jawher-Mansour/MedTronic-Ventilator/ReadMe.txt

Open Source Ventilator from Medtronic 

Medtronic-PB-560
