jawher-Mansour/MedTronic-Ventilator/PB560 - Electrical Schematics/4096600.E01.001_Schma Carte Connexion Batterie IND02.pdf

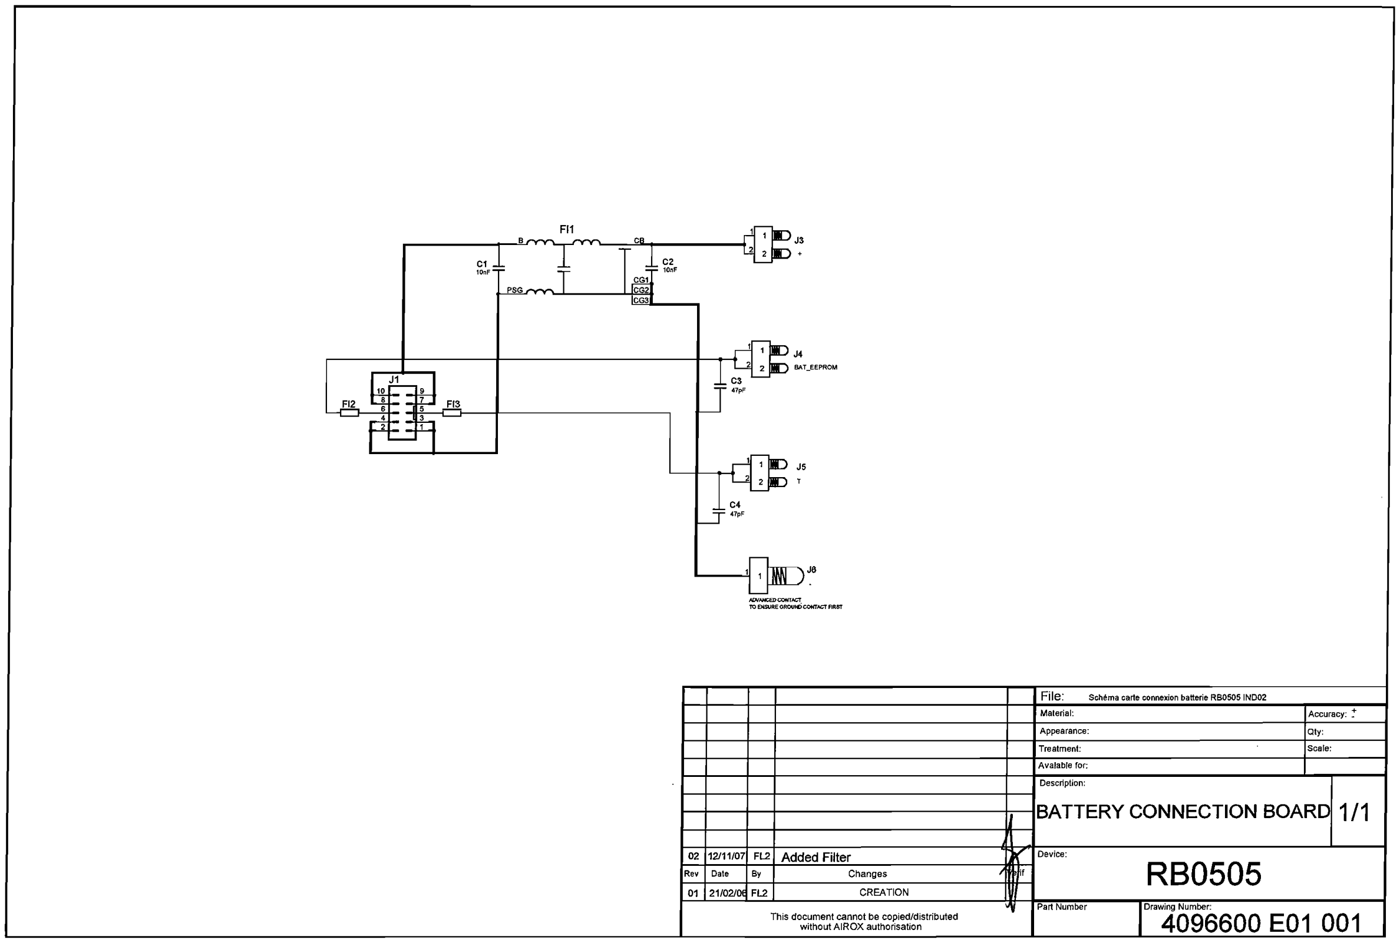
[picture p15: page 1]
