jawher-Mansour/MedTronic-Ventilator/Electronic PCBAs/10096510_Battery_Connection_PCBA/BOM/10096510_Battery_Connection_PCBA_BOM.xls

Creator | Jenaro | Julio
Type
Description
Title Block
Item Number | Description | Subclass | Lifecycle Phase | Rev | Rev Incorp Date | Rev Release Date | Effectivity Date
10096510 | BATTERY CONNECTION CARD RB0505 | Part | Production | A ECO-R252633 | 31/Jul/2013 05:52:42 PM BST | 06/Jan/2015 04:58:11 PM GMT
Page Two
UOM | Additional Categories Part | Alternate Part(s) | Alternate FG Part(s) | Restricted Access | Vendor User Group | Data Classification | Attachment Destination | Created By | Create Date | Legacy Data Source | Divesture Destination
Each | PART CATEGORY|Pc Board |  |  |  | V - Jabil SH | Confidential |  | Searcy, Teresa | 12/Jun/2012 01:54:35 PM BST | Agile RMS
Page Three
Product Family(s) | Item Type | Lot Serial Control | Document Number | RoHS Compliant | Bio Approval Number | Integration Description | Project(s) | Notes | Handling/Storage | Legacy Number
 | Customized | None | NODOCUMENT | Unknown |  | BATTERY CONNECTION CARD RB0505 | RSP - PB560-520 | Product Family : RSP - VENTILATOR SYSTEMS, Commodity Code: BPCS Add-Updt : FC02.17, Country of Origin: BPCS Add : FR = FRANCE, Shelf Life Days:BPCS Add-Updt : 0, Must Single Issue: BPCS Add : NO, Item Class: BPCS Add-Updt : GL-66 PB500 Series Ventilators/Gen 1, Controlled AML? : YES
BOM
Level | Attachments (Image) | Manufacturer (Image) | Pending Changes (Image) | Has Been Redlined (Image) | Has Quality(Image) | Bubble Number | Item Number | Item Description | Item Rev | Qty | UOM | Item Lifecycle Phase | BOM Notes | Ref Des | Component Effective From | Component Discontinue Date | Alternate Part(s) | Alternate FG Part(s) | Alternate Document(s) | Subclass | Sites | Planned? | Scrap Factor | OP # | Thumbnail | Attachments(Image) | Manufacture Part Has Redline | Mfr. Name | Mfr. Part Number | Mfr. Part Description | Mfr. Part Lifecycle Phase | Preferred Status | Sites | Reference Notes | RoHS Compliant? | RoHS Compliance Statement
1 | true | true | true | false | false | 0 | 10022508 | CAPACITOR CERAMIC,10NF,+/-10%,50V,0603 | C ECO-R252633 | 2 | Each | Production |  | C1,C2 |  |  |  |  |  | Part | BDRM |  | 1 |  |  | true | false | YAGEO_RMS1 | 223858615636 | CAPACITOR, CERAMIC, MULTILAYER, 50 V, X7R, 0.01 UF, SURFACE MOUNT, 0603 | Active | Preferred |  | BRAND: PHYCOMP | Yes | Legacy Inventory Status: Cleared
 |  |  |  |  |  |  |  |  |  |  |  |  |  |  |  |  |  |  |  |  |  |  |  |  |  | true | false | YAGEO_RMS1 | 223858615536 | CAPACITOR, CERAMIC, MULTILAYER, 50 V, X7R, 0.01 UF, SURFACE MOUNT, 0603 | Active | Preferred |  | BRAND: PHYCOMP | Yes | Legacy Inventory Status: Cleared
 |  |  |  |  |  |  |  |  |  |  |  |  |  |  |  |  |  |  |  |  |  |  |  |  |  | true | false | KEMET_RMS1 | C0603C103K5RACTU | CERAMIC CHIP CAPACITOR | Active | Preferred |  |  | Yes | Legacy Inventory Status: Cleared
 |  |  |  |  |  |  |  |  |  |  |  |  |  |  |  |  |  |  |  |  |  |  |  |  |  | true | false | YAGEO_RMS1 | CC0603KRX7R9BB103 | CAPACITOR, CERAMIC, MULTILAYER, 50 V, X7R, 0.01 UF, SURFACE MOUNT, 0603 | Active | Preferred |  |  | Yes | Legacy Inventory Status: Cleared
1 | true | true | false | false | false | 0 | 10022532 | FILTER CC, 1MHZ-1GHZ, 10A, 50V | B EC130338 | 1 | Each | Production |  | FI1 |  |  |  |  |  | Part | BDRM |  | 1 |  |  | true | false | MURATA MANUFACTURING CO., LTD. | BNX002-01 | FILTER | Active | Preferred |  | ROHS EXEMPTION: 7(C)-1 | Yes - by exemption | Legacy Inventory Status: Cleared
 |  |  |  |  |  |  |  |  |  |  |  |  |  |  |  |  |  |  |  |  |  |  |  |  |  | true | false | MURATA MANUFACTURING CO., LTD. | BNX00201 | NOISE/EMI SUPPRESSION FILTER | Active | Preferred |  | ROHS EXEMPTION: 7(C)-1 | Yes - by exemption | Legacy Inventory Status: Cleared
 |  |  |  |  |  |  |  |  |  |  |  |  |  |  |  |  |  |  |  |  |  |  |  |  |  | true | false | MURATA MANUFACTURING CO., LTD. | BNX002-11 | NOISE/EMI SUPPRESSION FILTER | Active | Preferred |  |  | Yes | CLEARED
1 | true | true | false | false | false | 0 | 10022623 | CAPACITOR,47 PF,+/-5%,50V,0402 | C ECO-R252636 | 2 | Each | Production |  | C3,C4 |  |  |  |  |  | Part | BDRM |  | 1 |  |  | true | false | KEMET_RMS1 | C0402C470J5GAC | CAP,CER,SMT,0402,5%,50V,47PF | Active | Preferred |  |  | Yes | Legacy Inventory Status: Cleared
 |  |  |  |  |  |  |  |  |  |  |  |  |  |  |  |  |  |  |  |  |  |  |  |  |  | true | false | SAMSUNG_RMS1 | CL05C470JB5NNNC | CAP CER 47PF 50V 5% NP0 0402 | Active | Preferred |  |  | Yes | Legacy Inventory Status: Cleared
 |  |  |  |  |  |  |  |  |  |  |  |  |  |  |  |  |  |  |  |  |  |  |  |  |  | true | false | MURATA MANUFACTURING CO., LTD. | GRM1555C1H470JA01D | CAP CER 47PF 50V 5% NP0 0402 | Active | Preferred |  |  | Yes | Legacy Inventory Status: Cleared
 |  |  |  |  |  |  |  |  |  |  |  |  |  |  |  |  |  |  |  |  |  |  |  |  |  | true | false | KEMET_RMS1 | C0402C470J5GACTU | CAP,CER,SMT,0402,5%,50V,47PF | Active | Preferred |  | TAPE & REEL | Yes | Legacy Inventory Status: Cleared
 |  |  |  |  |  |  |  |  |  |  |  |  |  |  |  |  |  |  |  |  |  |  |  |  |  | true | false | MURATA MANUFACTURING CO., LTD. | GRM1555C1H470JZ01D | MONOLITHIC CERAMIC CAPACITOR | Active | Preferred |  |  | Yes | Legacy Inventory Status: Cleared
1 | true | true | false | false | false | 0 | 10022907 | SMD FERRITE 200MA | B ECO-R252636 | 2 | Each | Production |  | FI2,FI3 |  |  |  |  |  | Part | BDRM |  | 1 |  |  | true | false | WURTH ELEKTRONIK GMBH | 74279266 | MULTILAYER-SMD-FERRITE | Active | Preferred |  | ROHS EXEMPT : 7(C)-1 | Yes | Legacy Inventory Status: Cleared
1 | true | true | true | false | false | 0 | 10023418 | CONNECTOR, 10 CONTACTS, HE10 | A ECO-R252633 | 1 | Each | Production |  | J1 |  |  |  |  |  | Part | BDRM |  | 1 |  |  | true | false | HARTING | 09185107323 | CONNECTOR | Active | Preferred |  |  | Yes | Legacy Inventory Status: Cleared
1 | true | true | false | false | false | 0 | 10023419 | CONNECTOR, 1 CONTACTS, TEST PROBE | A ECO-R252636 | 1 | Each | Production |  | J6 |  |  |  |  |  | Part | BDRM |  | 1 |  |  | true | false | INGUN | GKS 913 305 230 A 15 02 S | TEST PROBE | Active | Preferred |  |  | Yes | Legacy Inventory Status: Cleared
1 | true | true | false | false | false | 0 | 10023420 | CONNECTOR, 2 CONTACTS, PIN SPACE 2.54, SM | B ECO-R252636 | 3 | Each | Production |  | J3,J4,J5 |  |  |  |  |  | Part | BDRM |  | 1 |  |  | true | false | PRECI-DIP (015220) | 811-S1-002-30-014101 |  | Active | Preferred |  | ROHS EXEMPTION: 6(C) | Yes - by exemption | Legacy Inventory Status: Cleared
1 | true | true | true | false | false | 0 | 10096506 | PRINTED CIRCUIT, BATTERY BOARD | A MC002637 | 1 | Each | Production |  |  |  |  |  |  |  | Part | BDRM |  | 1 |  |  | true | false | TTM | 10096506 |  | Active | Preferred |  |  | Yes | Legacy Inventory Status: Cleared
1 | true | false | true | false | false | 0 | 4096600.E01.001 | BATTERY CONNECTION BOARD SCH | 02 ECO-R256396 | 1 |  | Production |  |  |  |  |  |  |  | Document | BDRM |  | 1
1 | true | true | true | false | false | 1 | 3838600 | PC BOARD TRACABILITY LABEL | C ECO-R252633 | 1 | Each | Production |  |  |  |  |  |  |  | Part | BDRM |  | 1 |  |  | true | false | BRADY_RMS1 | 3838600-H | B-727 LABEL, POLYIMIDE, GLOSSY WHITE THERMAL TRANSFER PRINTABLE LABEL STOCK | Active | Preferred |  | CUSTOM LABEL PER COVIDIEN DRAWING 3838600 | Yes | Legacy Inventory Status: Cleared
Manufacturers
Attachments(Image) | Manufacture Part Has Redline | Mfr. Name | Mfr. Part Number | Mfr. Part Description | Mfr. Part Lifecycle Phase | Preferred Status | Sites | Reference Notes | RoHS Compliant? | RoHS Compliance Statement
true | false | JABIL SUPPLIER - SHANGHAI UPP CO.,LTD.(LOC) | 10096510 |  | Active | Preferred |  | CUSTOM PART PER COVIDIEN P/N 10096510 | Yes | Legacy Inventory Status: Cleared
Attachments
Is Checked Out | Has Been Redlined | Filename | File Description | File Size | File Type | Attachment Type | Modified Date | Last View Date | Checkout User | Checkout Date | Checkout Location | Checkin User | Folder Number | Folder Version
false | false | 10096510_A_ECO-R231090.pdf | RMS Historical PDF - ECO-R231090 | 101554 | pdf |  | 17/Aug/2015 04:53:42 PM BST | 17/Aug/2015 04:53:42 PM BST |  |  |  | Migration, Data | FF0009842505 | 1
false | false | 10096510_A_ECO-R252633.pdf | RMS Historical PDF - ECO-R252633 | 101542 | pdf |  | 17/Aug/2015 04:53:43 PM BST | 17/Aug/2015 04:53:43 PM BST |  |  |  | Migration, Data | FF0009842506 | 1
false | false | 10096510X01.PDF | Redlined Rev-X01 to Rev-A | 49013 | PDF |  | 17/Jun/2015 06:58:52 AM BST | 17/Jun/2015 06:58:52 AM BST |  |  |  | Migration, Data | FF0007735014 | 1
false | false | 10096510A00.PDF | Approved Rev-A | 59009 | PDF |  | 17/Jun/2015 06:58:52 AM BST | 17/Jun/2015 06:58:52 AM BST |  |  |  | Migration, Data | FF0007735012 | 1
false | false | 10096510A00.zip | Approved Rev-A, Source Files | 1266803 | zip |  | 17/Jun/2015 06:58:52 AM BST | 17/Jun/2015 06:58:52 AM BST |  |  |  | Migration, Data | FF0007735017 | 1
