jawher-Mansour/MedTronic-Ventilator/Electronic PCBAs/10106052_PowerPack_PCBA/BOM/10106052_POWERPACK2 BOARD (DUAL BATTERY)_BOM.xls

Creator | Jenaro | Julio
Type
Description
Title Block
Item Number | Description | Subclass | Lifecycle Phase | Rev | Rev Incorp Date | Rev Release Date | Effectivity Date
10106052 | POWERPACK2 BOARD (DUAL BATTERY) | Part | Production | C ECO-R252636 | 05/Sep/2014 02:25:25 PM BST | 06/Jan/2015 05:10:58 PM GMT
Page Two
UOM | Additional Categories Part | Alternate Part(s) | Alternate FG Part(s) | Restricted Access | Vendor User Group | Data Classification | Attachment Destination | Created By | Create Date | Legacy Data Source | Divesture Destination
Each | PART CATEGORY|Pc Board |  |  |  | V - Jabil SH | Confidential |  | O'Connor, Martina | 07/Feb/2013 08:39:13 AM GMT | Agile RMS
Page Three
Product Family(s) | Item Type | Lot Serial Control | Document Number | RoHS Compliant | Bio Approval Number | Integration Description | Project(s) | Notes | Handling/Storage | Legacy Number
 | Customized | None | NODOCUMENT | Unknown |  | POWERPACK2 BOARD (DUAL BATTERY) | RSP - PB540 (ROHS N/A);RSP - PB560-520 | Product Family : RSP - VENTILATOR SYSTEMS, Commodity Code: BPCS Add-Updt : FC02.17, Country of Origin: BPCS Add : CN = CHINA, Shelf Life Days:BPCS Add-Updt : 0, Must Single Issue: BPCS Add : NO, Item Class: BPCS Add-Updt : GL-66 PB500 Series Ventilators/Gen 1
BOM
Level | Attachments (Image) | Manufacturer (Image) | Pending Changes (Image) | Has Been Redlined (Image) | Has Quality(Image) | Bubble Number | Item Number | Item Description | Item Rev | Qty | UOM | Item Lifecycle Phase | BOM Notes | Ref Des | Component Effective From | Component Discontinue Date | Alternate Part(s) | Alternate FG Part(s) | Alternate Document(s) | Subclass | Sites | Planned? | Scrap Factor | OP # | Thumbnail | Attachments(Image) | Manufacture Part Has Redline | Mfr. Name | Mfr. Part Number | Mfr. Part Description | Mfr. Part Lifecycle Phase | Preferred Status | Sites | Reference Notes | RoHS Compliant? | RoHS Compliance Statement
1 | true | true | false | false | false | 0 | 10000836 | RESISTOR 66,5K OHM, 0,063W, +/-0,1%, 0603 | A ECO-R252636 | 1 | Each | Production |  | R28 |  |  |  |  |  | Part | CBRM |  | 1 |  |  | true | false | WELWYN | PCF0603R-66K5BT1 |  | Active | Preferred |  |  | Yes | Legacy Inventory Status: Cleared
1 | true | true | false | false | false | 0 | 10000838 | RESISTOR 0,015 OHM, 2W, +/-1%, 2512 | A ECO-R252636 | 1 | Each | Production |  | R24 |  |  |  |  |  | Part | CBRM |  | 1 |  |  | true | false | WELWYN | LRF2512-R015FW |  | Active | Preferred |  | EXEMPTION LIST- 7(C)-I | Yes | Legacy Inventory Status: Cleared
1 | true | true | false | false | false | 0 | 10001204 | RES 100K OHM 1/10W 1% 0603 SMD | A MC002255 | 4 | Each | Production |  | R3,R11,R16,R27 |  |  |  |  |  | Part | CBRM |  | 1 |  |  | true | false | YAGEO_RMS1 | RC0603FR-07100KL | RESISTOR, METAL GLAZE/THICK FILM, 0.1 W, 1 %, 100 PPM, 100000 OHM, SURFACE MOUNT, 0603 | Active | Preferred |  |  | Yes - by exemption | RoHS compliant with 7(c)-I exemption and the exemption will be expired in 21 July 2021 for medical devices
 |  |  |  |  |  |  |  |  |  |  |  |  |  |  |  |  |  |  |  |  |  |  |  |  |  | true | false | PANASONIC_RMS1 | ERJ-3EKF1003V | RES 100K OHM 1/10W 1% 0603 SMD | Active | Preferred |  |  | Yes - by exemption | Rohs compliant with 7(c)-1 exemption and the exemption will be expired on 21/July/2021 for medical device
1 | false | true | false | false | false | 0 | 10002095 | MOSFET N-CH 60V 115MA SOT23-3 | C EC014944 | 5 | Each | Production |  | T1,T6,T7,T10,T15 |  |  |  |  |  | Part | CBRM |  | 1 |  |  | true | false | ON SEMICONDUCTOR | 2N7002LT1G | TRANS MOSFET N SOT23 | Active | Preferred |  |  | Yes | Per manufacturer RoHS and material declaration, part has a "G" prefix and does not contain any lead die. Thus, it is RoHS compliant with no exemptions.
 |  |  |  |  |  |  |  |  |  |  |  |  |  |  |  |  |  |  |  |  |  |  |  |  |  | true | false | DIODES INC | 2N7002-7-F | MOSFET N-CH 60V 115MA SOT23-3 | Active | Preferred |  |  | Yes | Legacy Inventory Status: Cleared
 |  |  |  |  |  |  |  |  |  |  |  |  |  |  |  |  |  |  |  |  |  |  |  |  |  | true | false | DIODES INC_RMS1 | 2N7002TA | MOSFET N-CH 60V 115MA SOT23-3 | Active | Preferred |  |  | Yes | Legacy Inventory Status: Cleared
1 | true | true | false | false | false | 0 | 10021053 | RELAY 24V 2POLES 8A RT2 | B ECO-R252636 | 1 | Each | Production |  | RL1 |  |  |  |  |  | Part | CBRM |  | 1 |  |  | true | false | FINDER | 41.52.9.024.0010 |  | Active | Preferred |  |  | Yes | Legacy Inventory Status: Cleared
1 | true | true | false | false | false | 0 | 10021070 | RESISTOR 40.2KOHM 0.1% 0.063W 0603 | A ECO-R252636 | 1 | Each | Production |  | R29 |  |  |  |  |  | Part | CBRM |  | 1 |  |  | true | false | WELWYN | PCF0603-R-40K2BT1 |  | Active | Preferred |  |  | Yes | Legacy Inventory Status: Cleared
1 | true | true | false | false | false | 0 | 10021350 | CONNECTOR 2 CONTACTS, 3.5A, HT 6.5MM | A ECO-R252636 | 6 | Each | Production |  | J1,J2,J3,J5,J6,J7 |  |  |  |  |  | Part | CBRM |  | 1 |  |  | true | false | ANTELEC | ACPD25410265 |  | Active | Alternate |  |  | Yes | Legacy Inventory Status: Cleared
 |  |  |  |  |  |  |  |  |  |  |  |  |  |  |  |  |  |  |  |  |  |  |  |  |  | true | false | PRECI-DIP (015220) | 811-S1-002-10-015101 |  | Active | Preferred |  | EXEMPTION LIST-EXCEPTION 6 | Yes - by exemption | Legacy Inventory Status: Cleared
1 | true | true | false | false | false | 0 | 10021365 | DIODE NETWORK ESD PROTECT 30 KV SOT457 | A ECO-R252636 | 4 | Each | Production |  | D10,D11,D12,D13 |  |  |  |  |  | Part | CBRM |  | 1 |  |  | true | false | NXP SEMICONDUCTORS_RMS1 | PESD5V0S4UD,115 | TVS DIODE 5V 13V 6TSOP | Active | Preferred |  |  | RoHS3 Compliant | Legacy Inventory Status: Cleared
1 | true | true | false | false | false | 0 | 10021369 | CAPACITOR CERAMIC 1UF 10V 10% X5R 0402 | A ECO-R252636 | 1 | Each | Production |  | C6 |  |  |  |  |  | Part | CBRM |  | 1 |  |  | true | false | KEMET_RMS1 | C0402C105K8PACTU |  | Active | Preferred |  |  | Yes | Legacy Inventory Status: Cleared
1 | true | true | false | false | false | 0 | 10021370 | CAPACITOR CERAMIC 10UF 6.3V 20% X5R 0603 | B ECO-R252636 | 2 | Each | Production |  | C2,C22 |  |  |  |  |  | Part | CBRM |  | 1 |  |  | true | false | KEMET_RMS1 | C0603C106M9PACTM |  | Active | Preferred |  |  | Yes | Legacy Inventory Status: Cleared
 |  |  |  |  |  |  |  |  |  |  |  |  |  |  |  |  |  |  |  |  |  |  |  |  |  | true | false | YAGEO_RMS1 | CC0603MRX5R5BB106 |  | Active | Preferred |  |  | Yes | Legacy Inventory Status: Cleared
 |  |  |  |  |  |  |  |  |  |  |  |  |  |  |  |  |  |  |  |  |  |  |  |  |  | true | false | MURATA_RMS1 | GRM188R60J106ME47D | CAPACITOR, 0603, 10UF, 6.3V | Active | Preferred |  |  | RoHS3 Compliant | Cleared
1 | true | true | false | false | false | 0 | 10021386 | CAPACITOR CERAMIC 100NF 50V 10% X7R 0603 | A ECO-R252636 | 10 | Each | Production |  | C1,C4,C5,C7,C11,C14,C23,C24,C25,C30 |  |  |  |  |  | Part | CBRM |  | 1 |  |  | true | false | KEMET_RMS1 | C0603C104K5RACTU | CAP,CER,SMT,0603,X7R,10%,50V,0.1UF | Active | Preferred |  |  | Yes | Legacy Inventory Status: Cleared
1 | true | true | true | false | false | 0 | 10022508 | CAPACITOR CERAMIC,10NF,+/-10%,50V,0603 | C ECO-R252633 | 2 | Each | Production |  | C10,C12 |  |  |  |  |  | Part | CBRM |  | 1 |  |  | true | false | YAGEO_RMS1 | 223858615636 | CAPACITOR, CERAMIC, MULTILAYER, 50 V, X7R, 0.01 UF, SURFACE MOUNT, 0603 | Active | Preferred |  | BRAND: PHYCOMP | Yes | Legacy Inventory Status: Cleared
 |  |  |  |  |  |  |  |  |  |  |  |  |  |  |  |  |  |  |  |  |  |  |  |  |  | true | false | YAGEO_RMS1 | 223858615536 | CAPACITOR, CERAMIC, MULTILAYER, 50 V, X7R, 0.01 UF, SURFACE MOUNT, 0603 | Active | Preferred |  | BRAND: PHYCOMP | Yes | Legacy Inventory Status: Cleared
 |  |  |  |  |  |  |  |  |  |  |  |  |  |  |  |  |  |  |  |  |  |  |  |  |  | true | false | KEMET_RMS1 | C0603C103K5RACTU | CERAMIC CHIP CAPACITOR | Active | Preferred |  |  | Yes | Legacy Inventory Status: Cleared
 |  |  |  |  |  |  |  |  |  |  |  |  |  |  |  |  |  |  |  |  |  |  |  |  |  | true | false | YAGEO_RMS1 | CC0603KRX7R9BB103 | CAPACITOR, CERAMIC, MULTILAYER, 50 V, X7R, 0.01 UF, SURFACE MOUNT, 0603 | Active | Preferred |  |  | Yes | Legacy Inventory Status: Cleared
1 | true | true | true | false | false | 0 | 10022515 | DIODE SCHOTTKY, 500MA,40V,SOD323 | C ECO-R252633 | 3 | Each | Production |  | D3,D4,D6 |  |  |  |  |  | Part | CBRM |  | 1 |  |  | true | false | NXP SEMICONDUCTORS_RMS1 | PMEG4005AEA,115 |  | Active | Preferred |  |  | Yes | Legacy Inventory Status: Cleared
 |  |  |  |  |  |  |  |  |  |  |  |  |  |  |  |  |  |  |  |  |  |  |  |  |  | true | false | NXP SEMICONDUCTORS_RMS1 | PMEG4005AEA | VERY LOW VF MEGA SCHOTTKY BARRIER RECTIFIERS | Active | Preferred |  |  | Yes | Legacy Inventory Status: Cleared
1 | true | true | false | false | false | 0 | 10022532 | FILTER CC, 1MHZ-1GHZ, 10A, 50V | B EC130338 | 1 | Each | Production |  | FL1 |  |  |  |  |  | Part | CBRM |  | 1 |  |  | true | false | MURATA MANUFACTURING CO., LTD. | BNX002-01 | FILTER | Active | Preferred |  | ROHS EXEMPTION: 7(C)-1 | Yes - by exemption | Legacy Inventory Status: Cleared
 |  |  |  |  |  |  |  |  |  |  |  |  |  |  |  |  |  |  |  |  |  |  |  |  |  | true | false | MURATA MANUFACTURING CO., LTD. | BNX00201 | NOISE/EMI SUPPRESSION FILTER | Active | Preferred |  | ROHS EXEMPTION: 7(C)-1 | Yes - by exemption | Legacy Inventory Status: Cleared
 |  |  |  |  |  |  |  |  |  |  |  |  |  |  |  |  |  |  |  |  |  |  |  |  |  | true | false | MURATA MANUFACTURING CO., LTD. | BNX002-11 | NOISE/EMI SUPPRESSION FILTER | Active | Preferred |  |  | Yes | CLEARED
1 | true | true | false | false | false | 0 | 10022548 | RESISTOR,10K OHM.0.063W,+/-1%,0603 | C ECO-R252636 | 12 | Each | Production |  | R1,R6,R7,R9,R10,R17,R19,R21,R30,R49,R53,R56 |  |  |  |  |  | Part | CBRM |  | 1 |  |  | true | false | YAGEO_RMS1 | RC0603FR-0710KL | RES 10.0K OHM 1/10W 1% 0603 SMD | Active | Preferred |  | EXEMPTION LIST-7(C)-I,CONTAINS LEAD IN GLASS OR CERAMIC OTHER THAN DIELECTRIC CERAMIC CAPACITOR | Yes - by exemption | Rohs Compliant with exemption 7(c)-I for lead in glass. Exemption expires on 21 July 2021 for Medical devices
 |  |  |  |  |  |  |  |  |  |  |  |  |  |  |  |  |  |  |  |  |  |  |  |  |  | true | false | SAMSUNG_RMS1 | RC1608F103CS | GENERAL PURPOSE CHIP RESISTOR | Active | Preferred |  | EXEMPTION LIST-7(C)-I,CONTAINS LEAD IN GLASS OR CERAMIC OTHER THAN DIELECTRIC CERAMIC CAPACITOR | Yes - by exemption | Legacy Inventory Status: Cleared
 |  |  |  |  |  |  |  |  |  |  |  |  |  |  |  |  |  |  |  |  |  |  |  |  |  | true | false | BOURNS_RMS1 | CR0603-FX-1002ELF | CHIP RESISTOR | Active | Preferred |  | EXEMPTION LIST-7(C)-I,CONTAINS LEAD IN GLASS OR CERAMIC OTHER THAN DIELECTRIC CERAMIC CAPACITOR | Yes - by exemption | Legacy Inventory Status: Cleared
 |  |  |  |  |  |  |  |  |  |  |  |  |  |  |  |  |  |  |  |  |  |  |  |  |  | true | false | YAGEO_RMS1 | 232270461003L | RESISTOR, METAL GLAZE/THICK FILM, 0.1 W, 1 %, 100 PPM, 10000 OHM, SURFACE MOUNT, 0603 | Active | Preferred |  | BRAND: PHYCOMP; EXEMPTION LIST-7(C)-I,CONTAINS LEAD IN GLASS OR CERAMIC OTHER THAN DIELECTRIC CERAMIC CAPACITOR | Yes - by exemption | Legacy Inventory Status: Cleared
1 | true | true | false | false | false | 0 | 10022551 | RESISTOR,4.7KOHM,0.063W,+/-1% | C ECO-R252636 | 1 | Each | Production |  | R41 |  |  |  |  |  | Part | CBRM |  | 1 |  |  | true | false | YAGEO_RMS1 | RC0603FR-074K7L | RESISTOR, METAL GLAZE/THICK FILM, 0.1 W, 1 %, 100 PPM, 4700 OHM, SURFACE MOUNT, 0603 | Active | Alternate |  | EXEMPTION LIST-7(C)-I,CONTAINS LEAD IN GLASS OR CERAMIC OTHER THAN DIELECTRIC CERAMIC CAPACITOR | Yes - by exemption | 2011/65/EU compliant with 7(c)-I exemption and the exemption will expired in 21 July 2021 for medical devices.
 |  |  |  |  |  |  |  |  |  |  |  |  |  |  |  |  |  |  |  |  |  |  |  |  |  | true | false | SAMSUNG_RMS1 | RC1608F472CS | LOW TOLERANCE CHIP RESISTOR | Active | Preferred |  | EXEMPTION LIST-7(C)-I,CONTAINS LEAD IN GLASS OR CERAMIC OTHER THAN DIELECTRIC CERAMIC CAPACITOR | Yes - by exemption | Legacy Inventory Status: Cleared
 |  |  |  |  |  |  |  |  |  |  |  |  |  |  |  |  |  |  |  |  |  |  |  |  |  | true | false | SAMSUNG_RMS1 | RC1608F4701CS | LOW TOLERANCE CHIP RESISTOR | Active | Preferred |  | EXEMPTION LIST-7(C)-I,CONTAINS LEAD IN GLASS OR CERAMIC OTHER THAN DIELECTRIC CERAMIC CAPACITOR | Yes - by exemption | Legacy Inventory Status: Cleared
 |  |  |  |  |  |  |  |  |  |  |  |  |  |  |  |  |  |  |  |  |  |  |  |  |  | true | false | YAGEO_RMS1 | 232270464702L | RESISTOR, METAL GLAZE/THICK FILM, 0.1 W, 1 %, 100 PPM, 4700 OHM, SURFACE MOUNT, 0603 | Active | Preferred |  | BRAND: PHYCOMP; EXEMPTION LIST-7(C)-I,CONTAINS LEAD IN GLASS OR CERAMIC OTHER THAN DIELECTRIC CERAMIC CAPACITOR | Yes - by exemption | Legacy Inventory Status: Cleared
1 | true | true | false | false | false | 0 | 10022554 | RESISTOR, 1K OHM, 0.063W,+/-1%, 0603 | C ECO-R252636 | 13 | Each | Production |  | R33,R34,R35,R36,R37,R38,R39,R40,R42,R43,R45,R46,R47 |  |  |  |  |  | Part | CBRM |  | 1 |  |  | true | false | BOURNS_RMS1 | CR0603-FX-1001ELF | CHIP RESISTOR | Active | Preferred |  | EXEMPTION LIST-7(C)-I,CONTAINS LEAD IN GLASS OR CERAMIC OTHER THAN DIELECTRIC CERAMIC CAPACITOR | Yes - by exemption | Legacy Inventory Status: Cleared
 |  |  |  |  |  |  |  |  |  |  |  |  |  |  |  |  |  |  |  |  |  |  |  |  |  | true | false | SAMSUNG_RMS1 | RC1608F1001CS |  | Active | Alternate |  | EXEMPTION LIST-7(C)-I,CONTAINS LEAD IN GLASS OR CERAMIC OTHER THAN DIELECTRIC CERAMIC CAPACITOR | Yes - by exemption | Legacy Inventory Status: Cleared
 |  |  |  |  |  |  |  |  |  |  |  |  |  |  |  |  |  |  |  |  |  |  |  |  |  | true | false | SAMSUNG_RMS1 | RC1608F1001ES | PRECISION CHIP RESISTOR | Active | Preferred |  | EXEMPTION LIST-7(C)-I,CONTAINS LEAD IN GLASS OR CERAMIC OTHER THAN DIELECTRIC CERAMIC CAPACITOR | Yes - by exemption | Legacy Inventory Status: Cleared
 |  |  |  |  |  |  |  |  |  |  |  |  |  |  |  |  |  |  |  |  |  |  |  |  |  | true | false | YAGEO_RMS1 | RC0603FR-071KL | RESISTOR, METAL GLAZE/THICK FILM, 0.1 W, 1 %, 100 PPM, 1000 OHM, SURFACE MOUNT, 0603 | Active | Preferred |  | EXEMPTION LIST-7(C)-I,CONTAINS LEAD IN GLASS OR CERAMIC OTHER THAN DIELECTRIC CERAMIC CAPACITOR | Yes | Legacy Inventory Status: Cleared
1 | true | true | false | false | false | 0 | 10022734 | RESISTOR,47K OHM,0.063W,+/-1%,0603 | B ECO-R252636 | 1 | Each | Production |  | R55 |  |  |  |  |  | Part | CBRM |  | 1 |  |  | true | false | YAGEO_RMS1 | RC0603FR-0747KL | RESISTOR, METAL GLAZE/THICK FILM, 0.1 W, 1 %, 100 PPM, 47000 OHM, SURFACE MOUNT, 0603 | Active | Preferred |  | ROHS EXEMPT: 7(C)-1 | Yes - by exemption | Legacy Inventory Status: Cleared
 |  |  |  |  |  |  |  |  |  |  |  |  |  |  |  |  |  |  |  |  |  |  |  |  |  | true | false | YAGEO_RMS1 | 232270464703L | RESISTOR, METAL GLAZE/THICK FILM, 0.1 W, 1 %, 100 PPM, 47000 OHM, SURFACE MOUNT, 0603 | Active | Preferred |  | BRAND: PHYCOMP. ROHS EXEMPT: 7(C)-1 | Yes - by exemption | Legacy Inventory Status: Cleared
 |  |  |  |  |  |  |  |  |  |  |  |  |  |  |  |  |  |  |  |  |  |  |  |  |  | true | false | BOURNS_RMS1 | CR0603-FX-473ELF | CHIP RESISTOR | Active | Preferred |  | ROHS EXEMPT: 7(C)-1 | Yes - by exemption | Legacy Inventory Status: Cleared
1 | true | true | false | false | false | 0 | 10022891 | IC,CURRENT SHUNT MONITOR,MSOP | A ECO-R252636 | 1 | Each | Production |  | U3 |  |  |  |  |  | Part | CBRM |  | 1 |  |  | true | false | TEXAS INSTRUMENTS_RMS1 | INA170EA | CURRENT SHUNT MONITOR | Active | Preferred |  | ROHS EMEMPTION: 15 | Yes | Legacy Inventory Status: Cleared
 |  |  |  |  |  |  |  |  |  |  |  |  |  |  |  |  |  |  |  |  |  |  |  |  |  | true | false | TEXAS INSTRUMENTS_RMS1 | INA170EA/2K5 | CURRENT SHUNT MONITOR | Active | Preferred |  | TAPE & REEL, 2500, ROHS EMEMPTION: 15 | Yes | Legacy Inventory Status: Cleared
 |  |  |  |  |  |  |  |  |  |  |  |  |  |  |  |  |  |  |  |  |  |  |  |  |  | true | false | TEXAS INSTRUMENTS_RMS1 | INA170EA/250 | CURRENT SHUNT MONITOR | Active | Preferred |  | TAPE & REEL, 250, ROHS EMEMPTION: 15 | Yes | Legacy Inventory Status: Cleared
1 | true | true | false | false | false | 0 | 10022896 | IC,VOLTAGE REFERENCE,5MA,3V +/-2%,SOT23 | B ECO-R252636 | 1 | Each | Production |  | U2 |  |  |  |  |  | Part | CBRM |  | 1 |  |  | true | false | NATIONAL SEMICONDUCTOR_RMS1 | LM4120AIM5-3.0/NOPB | LOW POWER VOLTAGE REFERENCE | Active | Preferred |  |  | Yes | Legacy Inventory Status: Cleared
1 | true | true | false | false | false | 0 | 10023238 | RESISTOR, 15K OHM, 0603, +/-1% | D ECO-R252636 | 5 | Each | Production |  | R2,R12,R18,R22,R54 |  |  |  |  |  | Part | CBRM |  | 1 |  |  | true | false | ASJ | CR16153FL |  | Active | Preferred |  | ROHS EXEMPT : 7(C)1 | Yes - by exemption | Legacy Inventory Status: Cleared
 |  |  |  |  |  |  |  |  |  |  |  |  |  |  |  |  |  |  |  |  |  |  |  |  |  | true | false | VISHAY_RMS1 | CRCW060315K0FKEA | THICK FILM RECTANGULAR CHIP RESISTOR | Active | Preferred |  | ROHS EXEMPT : 7(C)1 | Yes | Legacy Inventory Status: Cleared
 |  |  |  |  |  |  |  |  |  |  |  |  |  |  |  |  |  |  |  |  |  |  |  |  |  | true | false | YAGEO_RMS1 | 232270461503L | RESISTOR, METAL GLAZE/THICK FILM, 0.1 W, 1 %, 100 PPM, 15000 OHM, SURFACE MOUNT, 0603 | Active | Preferred |  | BRAND: PHYCOMP. ROHS EXEMPT : 7(C)1 | Yes - by exemption | Legacy Inventory Status: Cleared
 |  |  |  |  |  |  |  |  |  |  |  |  |  |  |  |  |  |  |  |  |  |  |  |  |  | true | false | YAGEO_RMS1 | RC0603FR-0715KL | RESISTOR, METAL GLAZE/THICK FILM, 0.1 W, 1 %, 100 PPM, 15000 OHM, SURFACE MOUNT, 0603 | Active | Preferred |  | ROHS EXEMPT : 7(C)1 | Yes - by exemption | Legacy Inventory Status: Cleared
 |  |  |  |  |  |  |  |  |  |  |  |  |  |  |  |  |  |  |  |  |  |  |  |  |  | true | false | YAGEO_RMS1 | 232270461503 | RESISTOR, METAL GLAZE/THICK FILM, 0.1 W, 1 %, 100 PPM, 15000 OHM, SURFACE MOUNT, 0603 | Active | Preferred |  | BRAND: PHYCOMP. ROHS EXEMPT : 7(C)1 | Yes - by exemption | Legacy Inventory Status: Cleared
1 | true | true | false | false | false | 0 | 10023419 | CONNECTOR, 1 CONTACTS, TEST PROBE | A ECO-R252636 | 2 | Each | Production |  | J4,J8 |  |  |  |  |  | Part | CBRM |  | 1 |  |  | true | false | INGUN | GKS 913 305 230 A 15 02 S | TEST PROBE | Active | Preferred |  |  | Yes | Legacy Inventory Status: Cleared
1 | true | true | false | false | false | 0 | 10049136 | RESISTOR 4.7K OHM 1/4W 5% 1206 | B ECO-R252636 | 1 | Each | Production |  | R44 |  |  |  |  |  | Part | CBRM |  | 1 |  |  | true | false | VISHAY_RMS1 | CRCW12064K70JNEA | RES,4.7K, 5%, 1/4W, 1206, SMT | Active | Preferred |  | EXEMPTION LIST-7(C)-I,CONTAINS LEAD IN GLASS OR CERAMIC OTHER THAN DIELECTRIC CERAMIC CAPACITOR | Yes - by exemption | 2011/65/EU compliant with 7(c)-I exemption and the exemption will expired in 21 July 2021 for medical devices.
 |  |  |  |  |  |  |  |  |  |  |  |  |  |  |  |  |  |  |  |  |  |  |  |  |  | true | false | ASJ | CR32-472-JL |  | Active | Preferred |  | EXEMPTION LIST-7(C)-I,CONTAINS LEAD IN GLASS OR CERAMIC OTHER THAN DIELECTRIC CERAMIC CAPACITOR | Yes - by exemption | Legacy Inventory Status: Cleared
 |  |  |  |  |  |  |  |  |  |  |  |  |  |  |  |  |  |  |  |  |  |  |  |  |  | true | false | YAGEO_RMS1 | RC1206JR-074K7L | RES,4.7K, 5%, 1/4W, 1206, SMT | Active | Preferred |  | EXEMPTION LIST-7(C)-I,CONTAINS LEAD IN GLASS OR CERAMIC OTHER THAN DIELECTRIC CERAMIC CAPACITOR | Yes - by exemption | 2011/65/EU compliant with 7(c)-I exemption and the exemption will expired in 21 July 2021 for medical devices.
1 | true | true | false | false | false | 0 | 10060347 | DIODE TRANSIL 33V, SMA | A ECO-R252636 | 4 | Each | Production |  | D1,D7,D9,D14 |  |  |  |  |  | Part | CBRM |  | 1 |  |  | true | false | ST MICROELECTRONICS_RMS1 | SMA6J28A-TR | HIGH JUNCTION TEMPERATURE TRANSIL | Active | Preferred |  | EXEMPTION LIST-7A. LEAD IN HIGH MELTING TEMPERATURE TYPE SOLDERS (I.E. LEAD BASED SOLDER ALLOYS CONTAINING 85% BY WEIGHT OR MORE LEAD). | Yes - by exemption | Legacy Inventory Status: Cleared
1 | true | true | false | false | false | 0 | 10060350 | CONNECTOR, ZH, 5 CIRCUITS, 1.5 MM | A ECO-R252636 | 1 | Each | Production |  | J13 |  |  |  |  |  | Part | CBRM |  | 1 |  |  | true | false | J.S.T. CORPORATION | S5B-ZR-SM4A-TF | ZH CONNECTOR | Active | Preferred |  |  | Yes | Legacy Inventory Status: Cleared
1 | true | true | false | false | false | 0 | 10060356 | TRANSISTOR MOS P CHANNEL, 60V, 1.6A, SOT23 | A ECO-R252636 | 1 | Each | Production |  | T3 |  |  |  |  |  | Part | CBRM |  | 1 |  |  | true | false | VISHAY_RMS1 | SI2309CDS-T1-GE3 | P-CHANNEL 60-V (D-S) MOSFET | Active | Preferred |  |  | Yes | Legacy Inventory Status: Cleared
1 | true | true | true | false | false | 0 | 10095972 | TRANSISTOR MOSFET, 60V, 50A, P CHANNEL | A ECO-R255176 | 5 | Each | Production |  | T2,T4,T8,T9,T14 |  |  |  |  |  | Part | CBRM |  | 1 |  |  | true | false | VISHAY_RMS1 | SUD50P06-15L-E3 |  | Active | Preferred |  | ROHS | Yes - by exemption | RoHS exemption 7a
1 | true | false | false | false | false | 0 | 10105965 | SCHEMATIC DIAGRAM, POWERPACK2 BOARD, PB500 | B ECO-R256396 | 1 |  | Production |  |  |  |  |  |  |  | Document | CBRM |  | 1
1 | true | true | false | false | false | 0 | 10106054 | FAB, PCB, POWERPACK2 BARE BOARD | A MC002637 | 1 | Each | Production |  |  |  |  |  |  |  | Part | CBRM |  | 1 |  |  | true | false | TTM | 10106054 |  | Active | Preferred |  |  | Yes | Legacy Inventory Status: Cleared
1 | true | true | false | false | false | 0 | 10107885 | CAP CER 1UF 50V X5R 10% 1210 | A ECO-R252636 | 1 | Each | Production |  | C3 |  |  |  |  |  | Part | CBRM |  | 1 |  |  | true | false | KEMET_RMS1 | C1210C105K5PAC |  | Active | Preferred |  |  | Yes | Legacy Inventory Status: Cleared
1 | true | true | false | false | false | 0 | 10107886 | CAP EL 100UF 20% 50V LOW ESR | A ECO-R252636 | 2 | Each | Production |  | C8,C9 |  |  |  |  |  | Part | CBRM |  | 1 |  |  | true | false | KEMET_RMS1 | ESW107M050AG3AA |  | Active | Preferred |  |  | Yes | Legacy Inventory Status: Cleared
1 | true | true | false | false | false | 0 | 10107888 | DIODE SCHOTTKY DUAL 70V 100MA SOT-23 | A ECO-R252636 | 1 | Each | Production |  | D5 |  |  |  |  |  | Part | CBRM |  | 1 |  |  | true | false | VISHAY_RMS1 | BAS70-05-E3-08 |  | Active | Preferred |  |  | Yes | Legacy Inventory Status: Cleared
1 | true | true | false | false | false | 0 | 10107889 | PTC RESETTABLE 33V 1.1A 2016 SMD | A ECO-R252636 | 1 | Each | Production |  | F1 |  |  |  |  |  | Part | CBRM |  | 1 |  |  | true | false | LITTELFUSE, INC. | 2016L100/33 |  | Active | Preferred |  |  | Yes | Legacy Inventory Status: Cleared
1 | true | true | false | false | false | 0 | 10107890 | HEADER 2 PIN FRICTION LOCK MOLEX KK 156 SERIES | A ECO-R252636 | 1 | Each | Production |  | J9 |  |  |  |  |  | Part | CBRM |  | 1 |  |  | true | false | MOLEX_RMS1 | 26-61-4020 |  | Active | Preferred |  |  | Yes | Legacy Inventory Status: Cleared
1 | true | true | false | false | false | 0 | 10107891 | CONNECTOR, ZH, 2 CIRCUITS, 1.5 MM | A ECO-R252636 | 1 | Each | Production |  | J10 |  |  |  |  |  | Part | CBRM |  | 1 |  |  | true | false | JST_RMS1 | S2B-ZR-SM4A-TF(LF)(SN) |  | Active | Preferred |  |  | Yes | Legacy Inventory Status: Cleared
1 | true | true | false | false | false | 0 | 10107892 | HEADER TH MOLEX MICRO-FIT 2 CIRCUITS 3MM 5A 250V | A ECO-R252636 | 1 | Each | Production |  | J11 |  |  |  |  |  | Part | CBRM |  | 1 |  |  | true | false | MOLEX_RMS1 | 43650-0229 |  | Active | Preferred |  |  | Yes | Legacy Inventory Status: Cleared
1 | true | true | false | false | false | 0 | 10107894 | CONNECTOR ZIF, 19 CONTACTS, 1 MM | A ECO-R252636 | 1 | Each | Production |  | J12 |  |  |  |  |  | Part | CBRM |  | 1 |  |  | true | false | MOLEX_RMS1 | 52207-1960 |  | Active | Alternate |  |  | Yes | Legacy Inventory Status: Cleared
 |  |  |  |  |  |  |  |  |  |  |  |  |  |  |  |  |  |  |  |  |  |  |  |  |  | true | false | MOLEX_RMS1 | 52207-1985 |  | Active | Preferred |  |  | Yes | Legacy Inventory Status: Cleared
1 | true | true | false | false | false | 0 | 10107895 | RESISTOR 470 OHM 1/8W 5% 1206 | A ECO-R252636 | 1 | Each | Production |  | R32 |  |  |  |  |  | Part | CBRM |  | 1 |  |  | true | false | YAGEO_RMS1 | RC1206JR-07470RL |  | Active | Preferred |  | ROHS EXEMPTION - 7( C )-1 ELECTRICAL AND ELECTRONIC COMPONENTS CONTAINING LEAD IN A GLASS. | Yes | Legacy Inventory Status: Cleared
 |  |  |  |  |  |  |  |  |  |  |  |  |  |  |  |  |  |  |  |  |  |  |  |  |  | true | false | VISHAY_RMS1 | CRCW1206470RJKEA |  | Active | Preferred |  | ROHS EXEMPTION - 7( C )-1 ELECTRICAL AND ELECTRONIC COMPONENTS CONTAINING LEAD IN A GLASS. | Yes | Legacy Inventory Status: Cleared
1 | true | true | false | false | false | 0 | 10107900 | IC LINEAR ACTIVE THERMISTOR MCP9700 TO-92 | A ECO-R252636 | 1 | Each | Production |  | U6 |  |  |  |  |  | Part | CBRM |  | 1 |  |  | true | false | MICROCHIP | MCP9700AT-E/TO |  | Active | Alternate |  |  | Yes | Legacy Inventory Status: Cleared
 |  |  |  |  |  |  |  |  |  |  |  |  |  |  |  |  |  |  |  |  |  |  |  |  |  | true | false | MICROCHIP | MCP9700A-E/TO |  | Active | Preferred |  |  | Yes | Legacy Inventory Status: Cleared
1 | true | true | false | false | false | 0 | 10113299 | RESISTOR 18 KOHM 0.063W +/-1% 0603 | A ECO-R252636 | 2 | Each | Production |  | R5,R15 |  |  |  |  |  | Part | CBRM |  | 1 |  |  | true | false | YAGEO_RMS1 | RC0603FR-0718KL |  | Active | Preferred |  | ROHS EXEMPTION - 7( C )-1 ELECTRICAL AND ELECTRONIC COMPONENTS CONTAINING LEAD IN A GLASS. | Yes - by exemption | Legacy Inventory Status: Cleared
1 | true | true | false | false | false | 0 | 10113300 | RESISTOR 22 KOHM 0.063W +/-1% 0603 | A ECO-R252636 | 6 | Each | Production |  | R8,R13,R20,R23,R31,R52 |  |  |  |  |  | Part | CBRM |  | 1 |  |  | true | false | YAGEO_RMS1 | RC0603JR-0722KL |  | Active | Preferred |  | ROHS EXEMPTION - 7( C )-1 ELECTRICAL AND ELECTRONIC COMPONENTS CONTAINING LEAD IN A GLASS. | Yes - by exemption | Legacy Inventory Status: Cleared
1 | true | true | false | false | false | 0 | 10113301 | RESISTOR 62 KOHM 0.063W +/-1% 0603 | A ECO-R252636 | 1 | Each | Production |  | R48 |  |  |  |  |  | Part | CBRM |  | 1 |  |  | true | false | YAGEO_RMS1 | RC0603FR-0762KL |  | Active | Preferred |  | ROHS EXEMPTION - 7( C )-1 ELECTRICAL AND ELECTRONIC COMPONENTS CONTAINING LEAD IN A GLASS. | Yes - by exemption | Legacy Inventory Status: Cleared
1 | true | true | false | false | false | 0 | 10113304 | IC REG LINEAR 5V/3.3V 350MA D2PAK-7 | A ECO-R252636 | 1 | Each | Production |  | U1 |  |  |  |  |  | Part | CBRM |  | 1 |  |  | true | false | ON SEMICONDUCTOR_RMS1 | NCV87725D7S50R4G |  | Active | Preferred |  |  | Yes | Legacy Inventory Status: Cleared
1 | true | true | false | false | false | 0 | 10126894 | MICROCONTROLLER PROGRAMMED - POWERPACK2 | A ECO-R252636 | 1 | Each | Production |  | U4 |  |  |  |  |  | Part | CBRM |  | 1 |  |  | true | false | MICROCHIP | 10126894 |  | Active | Preferred |  |  | Yes | Legacy Inventory Status: Cleared
1 | true | true | false | false | false | 0 | 10126895 | RESISTOR 68 OHM 1/4W 5% 1206 | A ECO-R252636 | 1 | Each | Production |  | R26 |  |  |  |  |  | Part | CBRM |  | 1 |  |  | true | false | VISHAY_RMS1 | CRCW120668RJKEA |  | Active | Preferred |  | ROHS EXEMPTION - 7( C )-1 ELECTRICAL AND ELECTRONIC COMPONENTS CONTAINING LEAD IN A GLASS. | Yes - by exemption | Legacy Inventory Status: Cleared
 |  |  |  |  |  |  |  |  |  |  |  |  |  |  |  |  |  |  |  |  |  |  |  |  |  | true | false | YAGEO_RMS1 | RC1206JR-0768RL |  | Active | Preferred |  | ROHS EXEMPTION - 7( C )-1 ELECTRICAL AND ELECTRONIC COMPONENTS CONTAINING LEAD IN A GLASS. | Yes - by exemption | Legacy Inventory Status: Cleared
1 | true | true | false | false | false | 0 | 312937 | RES,0OHM 1/8W 5% 1206 | C ECO-R252636 | 1 | Each | Production |  | R25 |  |  |  |  |  | Part | CBRM |  | 1 |  |  | true | false | PANASONIC (017670) | ERJ8GEY0R00V |  | Active | Preferred |  |  | RoHS3 Compliant with exemptions | RoHS3 Compliant with exemptions
1 | true | true | true | false | false | 0 | 3838600 | PC BOARD TRACABILITY LABEL | C ECO-R252633 | 1 | Each | Production |  |  |  |  |  |  |  | Part | CBRM |  | 1 |  |  | true | false | BRADY_RMS1 | 3838600-H | B-727 LABEL, POLYIMIDE, GLOSSY WHITE THERMAL TRANSFER PRINTABLE LABEL STOCK | Active | Preferred |  | CUSTOM LABEL PER COVIDIEN DRAWING 3838600 | Yes | Legacy Inventory Status: Cleared
1 | true | true | false | false | false | 0 | GR101899 | TVS AVAL DIODE ARRAY 2CH SC70-3 | A ECO-R253300 | 2 | Each | Production |  | D2,D8 |  |  |  |  |  | Part | CBRM |  | 1 |  |  | true | false | LITTLEFUSE | SP0502BAJTG |  | Active | Preferred |  |  | Yes | Legacy Inventory Status: Cleared
1 | true | true | false | false | false | 0 | GR102887 | MOSFET N-CH 30V SOT-23 | A MC007004 | 2 | Each | Production |  | T5,T11 |  |  |  |  |  | Part | CBRM |  | 1 |  |  | true | false | VISHAY_RMS1 | SI2300DS-T1-GE3 | MOSFET N-CH 30V SOT-23 | Active | Preferred |  |  | RoHS3 Compliant | Cleared
Manufacturers
Attachments(Image) | Manufacture Part Has Redline | Mfr. Name | Mfr. Part Number | Mfr. Part Description | Mfr. Part Lifecycle Phase | Preferred Status | Sites | Reference Notes | RoHS Compliant? | RoHS Compliance Statement
true | false | JABIL CIRCUIT_RMS1 | 10106052 |  | Active | Preferred |  |  | Yes | Legacy Inventory Status: Cleared
Attachments
Is Checked Out | Has Been Redlined | Filename | File Description | File Size | File Type | Attachment Type | Modified Date | Last View Date | Checkout User | Checkout Date | Checkout Location | Checkin User | Folder Number | Folder Version
false | false | 10106052C00.PDF | Approved Rev C, pdf | 107904 | PDF |  | 17/Jun/2015 10:18:43 AM BST | 17/Jun/2015 10:18:43 AM BST |  |  |  | Migration, Data | FF0007774796 | 1
false | false | 10106052_C_ECO-R252636.pdf | RMS Historical PDF - ECO-R252636 | 130544 | pdf |  | 27/Jun/2015 10:10:29 AM BST | 27/Jun/2015 10:10:29 AM BST |  |  |  | Migration, Data | FF0008969659 | 1
false | false | 10106052C00.zip | Approved Rev C, zip, source files | 4780293 | zip |  | 17/Jun/2015 10:18:43 AM BST | 17/Jun/2015 10:18:43 AM BST |  |  |  | Migration, Data | FF0007774798 | 1
false | false | 10106052_C_ECO-R249715.pdf | RMS Historical PDF - ECO-R249715 | 130552 | pdf |  | 27/Jun/2015 10:10:31 AM BST | 27/Jun/2015 10:10:32 AM BST |  |  |  | Migration, Data | FF0008969671 | 1
false | false | 10106052B00.pdf | Redlines Rev B to Rev C | 144004 | pdf |  | 17/Jun/2015 10:18:42 AM BST | 17/Jun/2015 10:18:42 AM BST |  |  |  | Migration, Data | FF0007774794 | 1
