jawher-Mansour/MedTronic-Ventilator/3D CAD Models/PB560 Assy/alimentation xp.sldasm

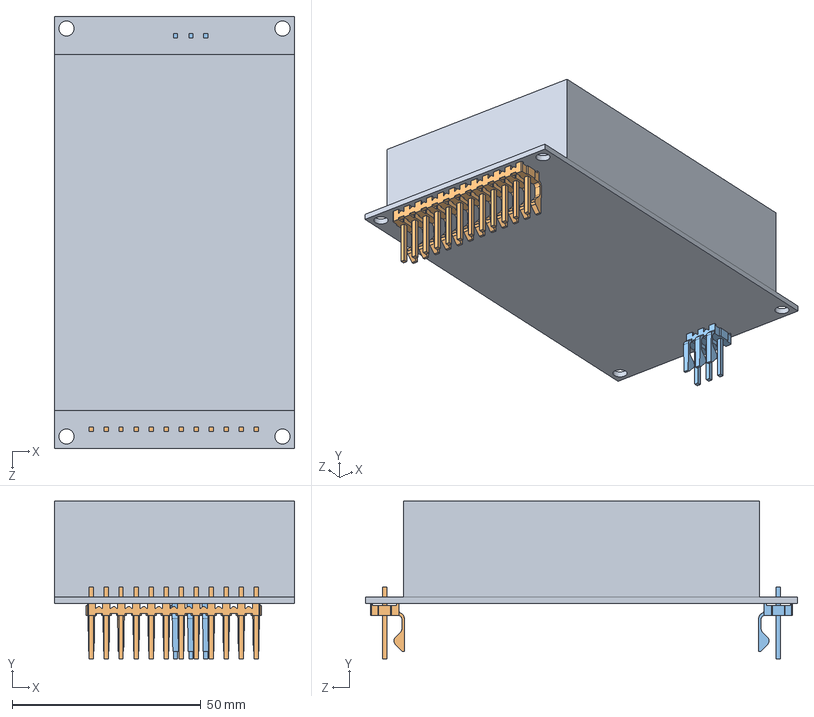
[picture p17: CAD file, 2020-04-03]
3D CAD Models/PB560 Assy/alimentation xp.sldasm
63.5 x 41.7 x 114.3 mm
alimentation phase 2
