jawher-Mansour/MedTronic-Ventilator/3D CAD Models/PB560 Assy/Batt PCB Assy.SLDASM

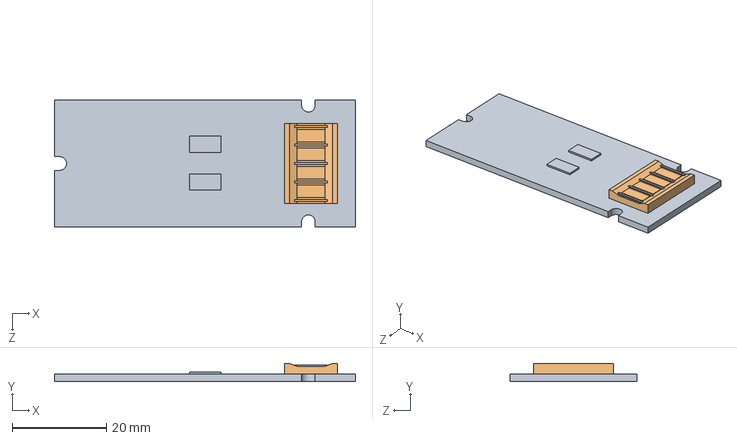
[picture p19: CAD file, 2020-04-03]
3D CAD Models/PB560 Assy/Batt PCB Assy.SLDASM
63.9 x 3.85 x 26.9 mm
Batt PCB
Batt Contacts tab
