jawher-Mansour/MedTronic-Ventilator/3D CAD Models/PB560 Assy/buzzer1.SLDPRT

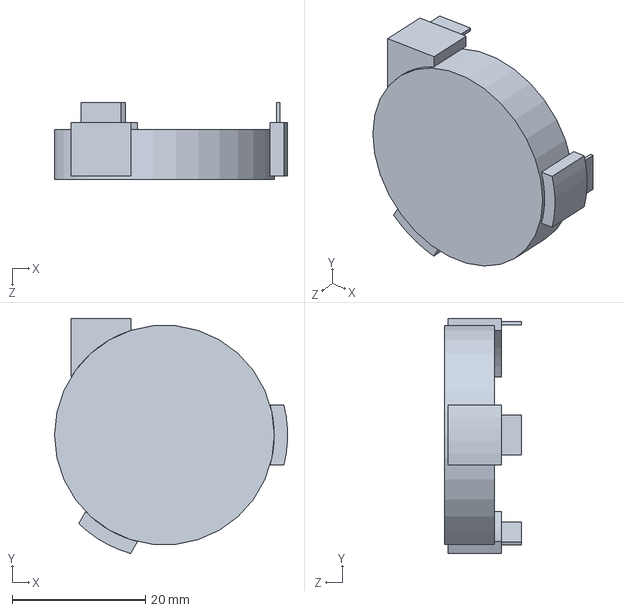
[picture p20: CAD file, 2020-04-03]
3D CAD Models/PB560 Assy/buzzer1.SLDPRT
35.0 x 35.3 x 11.5 mm
