jawher-Mansour/MedTronic-Ventilator/3D CAD Models/PB560 Assy/capteur pression absolue.SLDPRT

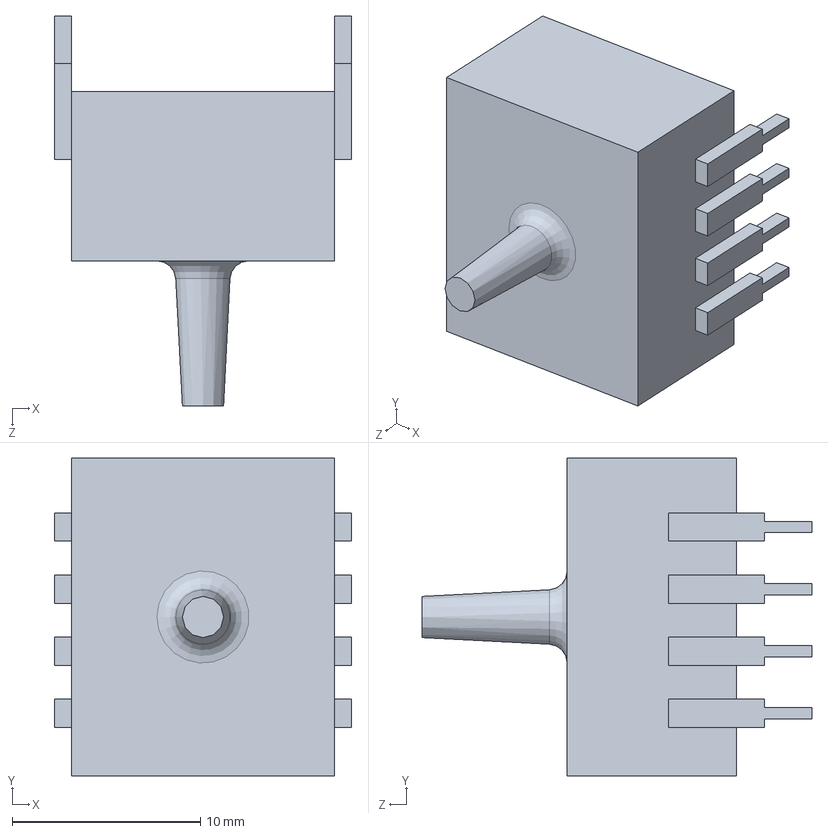
[picture p21: CAD file, 2020-04-03]
3D CAD Models/PB560 Assy/capteur pression absolue.SLDPRT
15.8 x 16.9 x 20.7 mm
