jawher-Mansour/MedTronic-Ventilator/3D CAD Models/PB560 Assy/connecteur USB miniB.SLDPRT

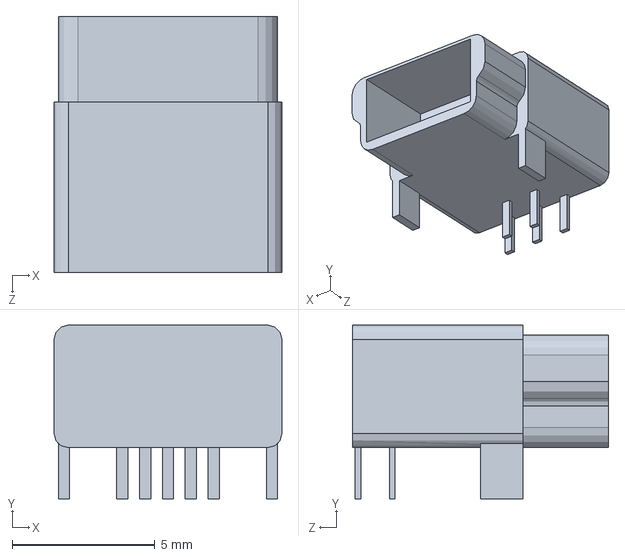
[picture p23: CAD file, 2020-04-03]
3D CAD Models/PB560 Assy/connecteur USB miniB.SLDPRT
8.00 x 6.10 x 9.00 mm
