jawher-Mansour/MedTronic-Ventilator/3D CAD Models/PB560 Assy/PRECI-DIP 811-S1-002-30-014101.SLDPRT

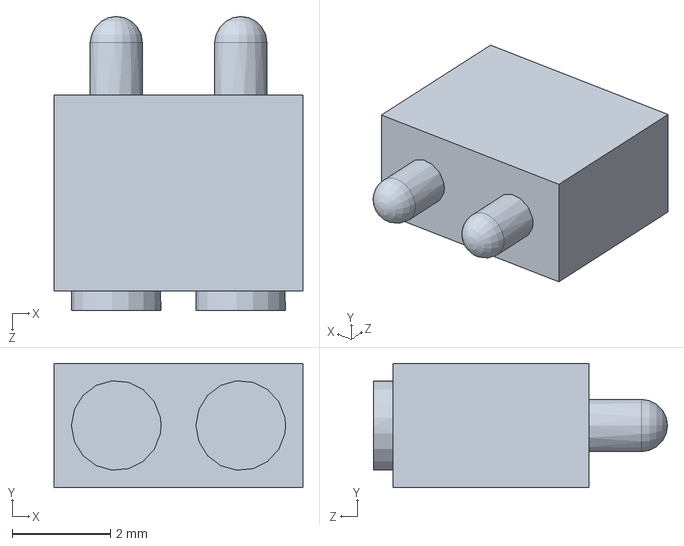
[picture p24: CAD file, 2020-04-03]
3D CAD Models/PB560 Assy/PRECI-DIP 811-S1-002-30-014101.SLDPRT
5.08 x 2.54 x 6.00 mm
