jawher-Mansour/MedTronic-Ventilator/3D CAD Models/PB560 Assy/feritte nappe afficheur.SLDPRT

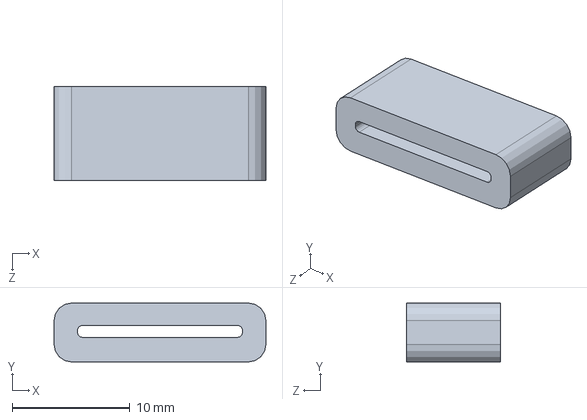
[picture p25: CAD file, 2020-04-03]
3D CAD Models/PB560 Assy/feritte nappe afficheur.SLDPRT
18.0 x 5.00 x 8.00 mm
