jawher-Mansour/MedTronic-Ventilator/3D CAD Models/PB560 Assy/capteurpressionASDX100D44R.SLDPRT

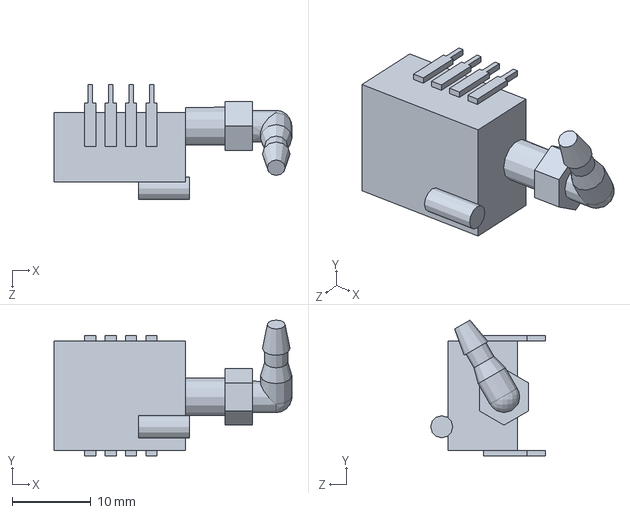
[picture p26: CAD file, 2020-04-03]
3D CAD Models/PB560 Assy/capteurpressionASDX100D44R.SLDPRT
30.2 x 17.2 x 14.5 mm
