jawher-Mansour/MedTronic-Ventilator/3D CAD Models/PB560 Assy/22-27-2021.SLDPRT

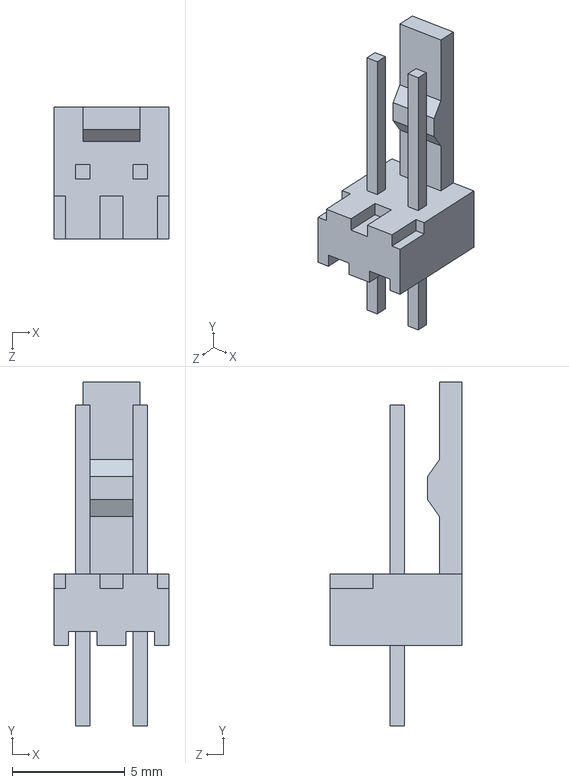
[picture p27: CAD file, 2020-04-03]
3D CAD Models/PB560 Assy/22-27-2021.SLDPRT
5.08 x 15.2 x 5.84 mm
