jawher-Mansour/MedTronic-Ventilator/3D CAD Models/PB560 Assy/1mm bumper.SLDPRT

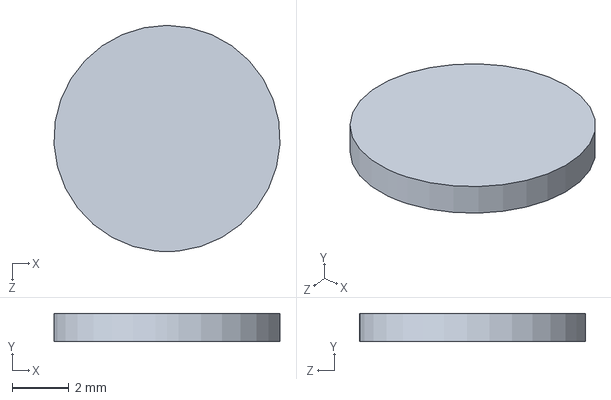
[picture p29: CAD file, 2020-04-03]
3D CAD Models/PB560 Assy/1mm bumper.SLDPRT
7.99 x 1.00 x 8.00 mm
