jawher-Mansour/MedTronic-Ventilator/3D CAD Models/PB560 Assy/I0 178 Entretoise AR Legendair.SLDPRT

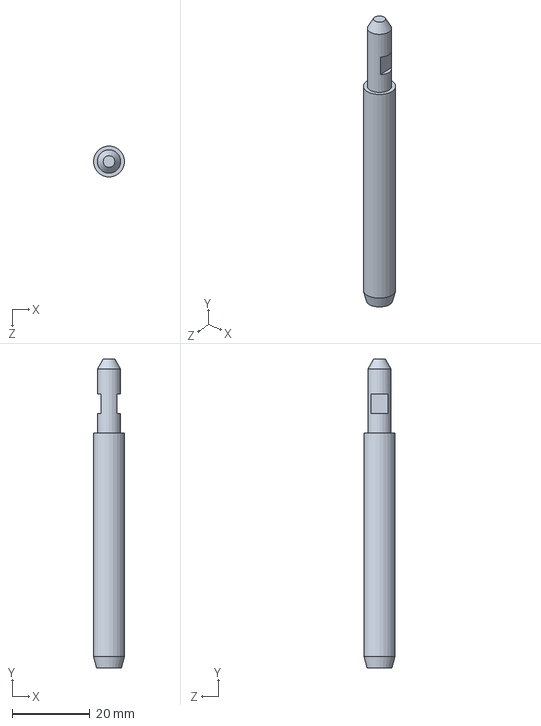
[picture p30: CAD file, 2020-04-03]
3D CAD Models/PB560 Assy/I0 178 Entretoise AR Legendair.SLDPRT
8.00 x 79.5 x 8.00 mm
