jawher-Mansour/MedTronic-Ventilator/3D CAD Models/PB560 Assy/tuyau alim vanne 4x6.SLDPRT

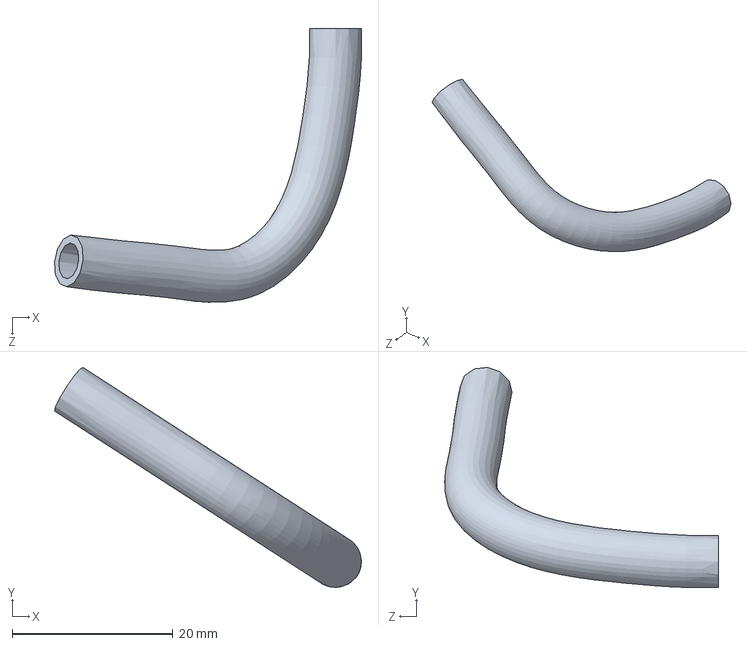
[picture p31: CAD file, 2020-04-03]
3D CAD Models/PB560 Assy/tuyau alim vanne 4x6.SLDPRT
38.2 x 27.4 x 34.1 mm
