jawher-Mansour/MedTronic-Ventilator/3D CAD Models/PB560 Assy/tuyau débit inspi P2.SLDPRT

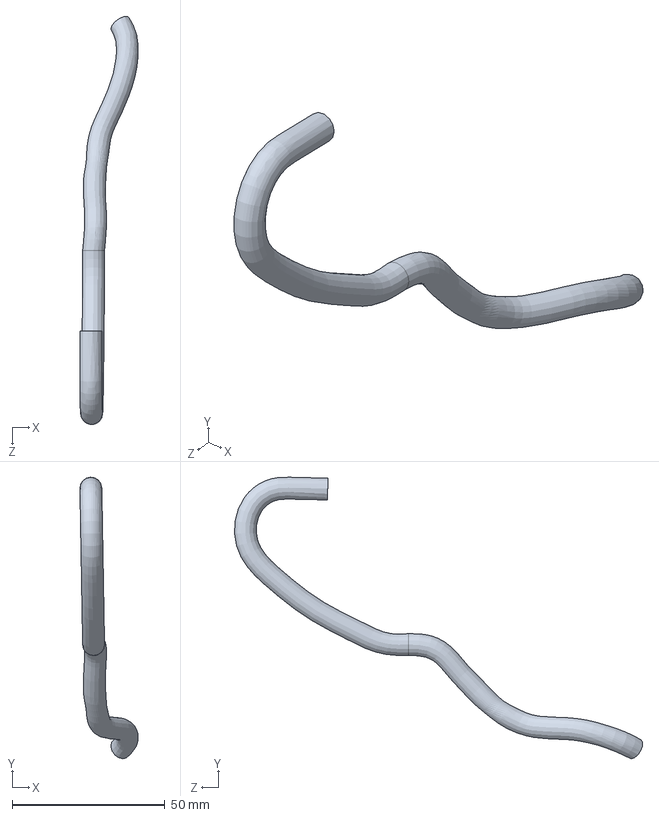
[picture p32: CAD file, 2020-04-03]
3D CAD Models/PB560 Assy/tuyau débit inspi P2.SLDPRT
19.1 x 92.3 x 133.7 mm
