jawher-Mansour/MedTronic-Ventilator/3D CAD Models/PB560 Assy/alimentation phase 2.SLDPRT

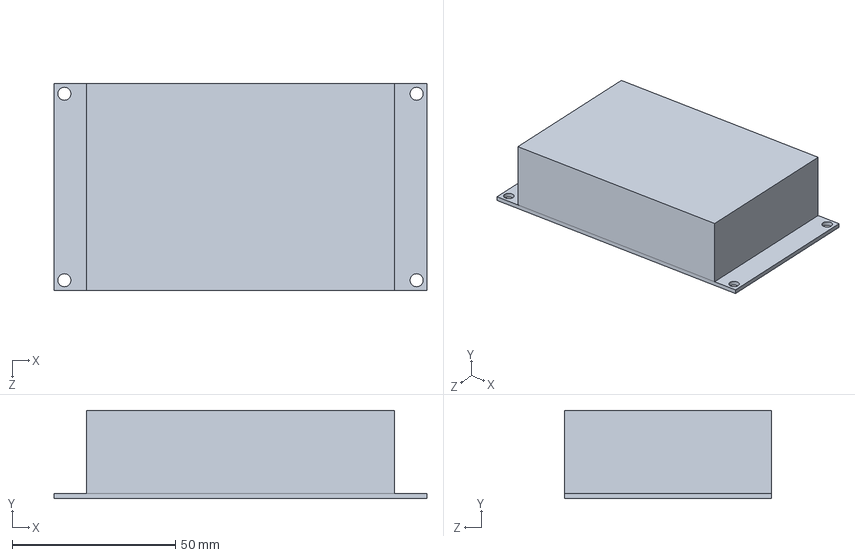
[picture p33: CAD file, 2020-04-03]
3D CAD Models/PB560 Assy/alimentation phase 2.SLDPRT
114.3 x 27.0 x 63.5 mm
