jawher-Mansour/MedTronic-Ventilator/3D CAD Models/PB560 Assy/702-09 Entretoise AV Legendair.SLDPRT

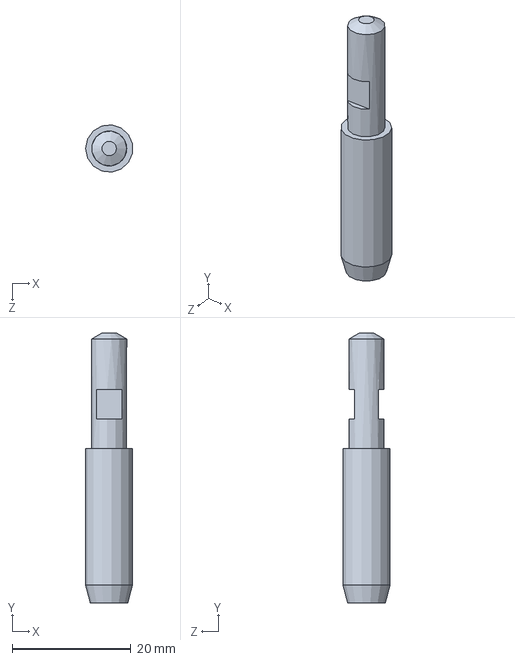
[picture p34: CAD file, 2020-04-03]
3D CAD Models/PB560 Assy/702-09 Entretoise AV Legendair.SLDPRT
7.91 x 45.5 x 7.96 mm
