jawher-Mansour/MedTronic-Ventilator/3D CAD Models/PB560 Assy/entretoise richco lg16.SLDPRT

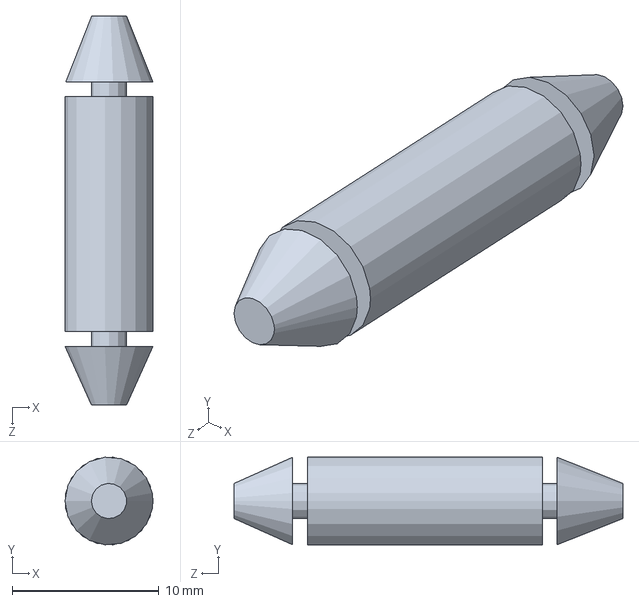
[picture p35: CAD file, 2020-04-03]
3D CAD Models/PB560 Assy/entretoise richco lg16.SLDPRT
6.00 x 5.97 x 26.5 mm
