jawher-Mansour/MedTronic-Ventilator/3D CAD Models/PB560 Assy/etiq reperage vanne O2.SLDPRT

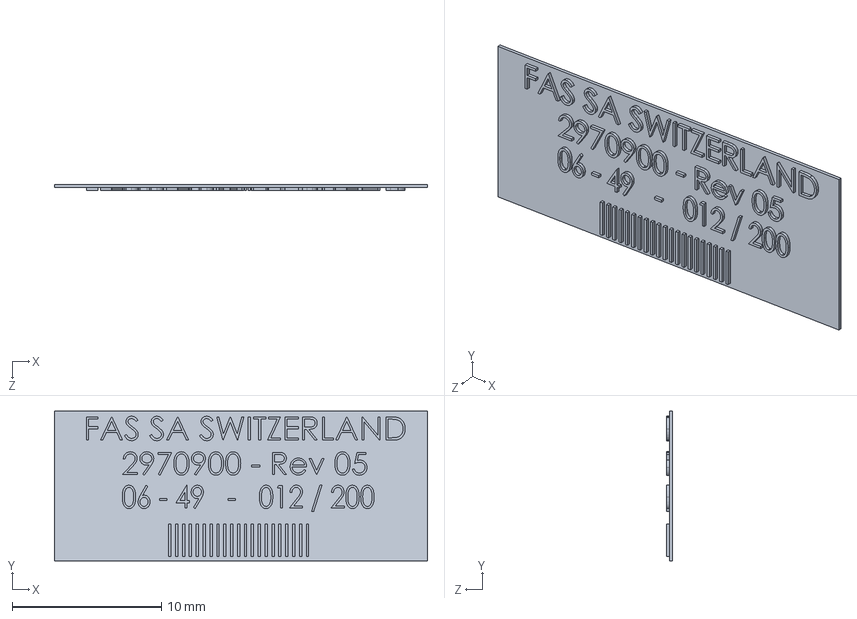
[picture p37: CAD file, 2020-04-03]
3D CAD Models/PB560 Assy/etiq reperage vanne O2.SLDPRT
25.0 x 10.0 x 0.4 mm
