jawher-Mansour/MedTronic-Ventilator/3D CAD Models/PB560 Assy/condensateur.SLDPRT

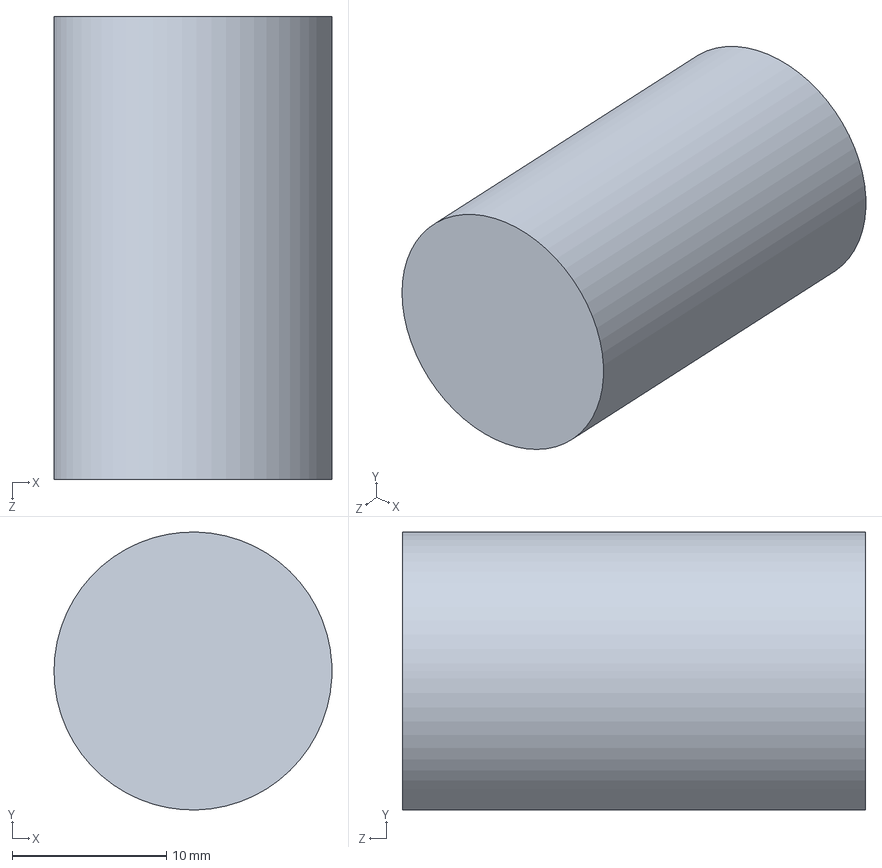
[picture p38: CAD file, 2020-04-03]
3D CAD Models/PB560 Assy/condensateur.SLDPRT
18.0 x 18.0 x 30.0 mm
