jawher-Mansour/MedTronic-Ventilator/3D CAD Models/PB560 Assy/Back End Cap.SLDPRT

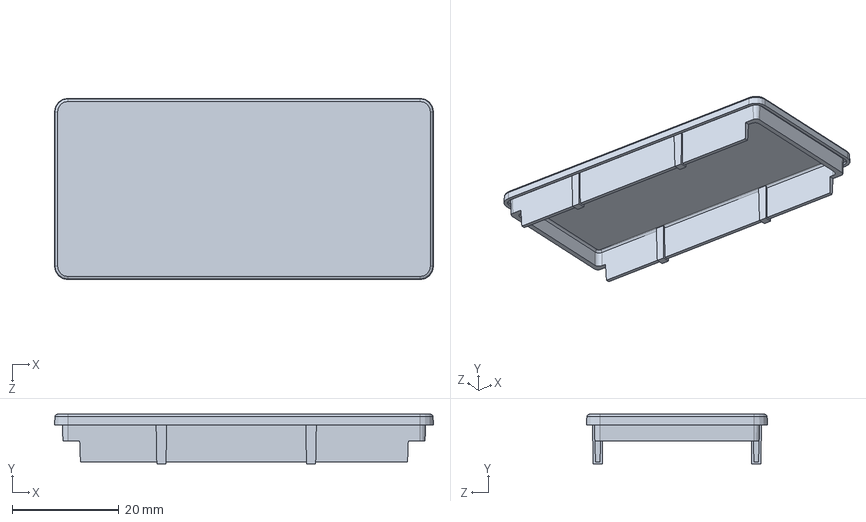
[picture p39: CAD file, 2020-04-03]
3D CAD Models/PB560 Assy/Back End Cap.SLDPRT
70.9 x 9.30 x 33.9 mm
