jawher-Mansour/MedTronic-Ventilator/3D CAD Models/PB560 Assy/self debout.SLDPRT

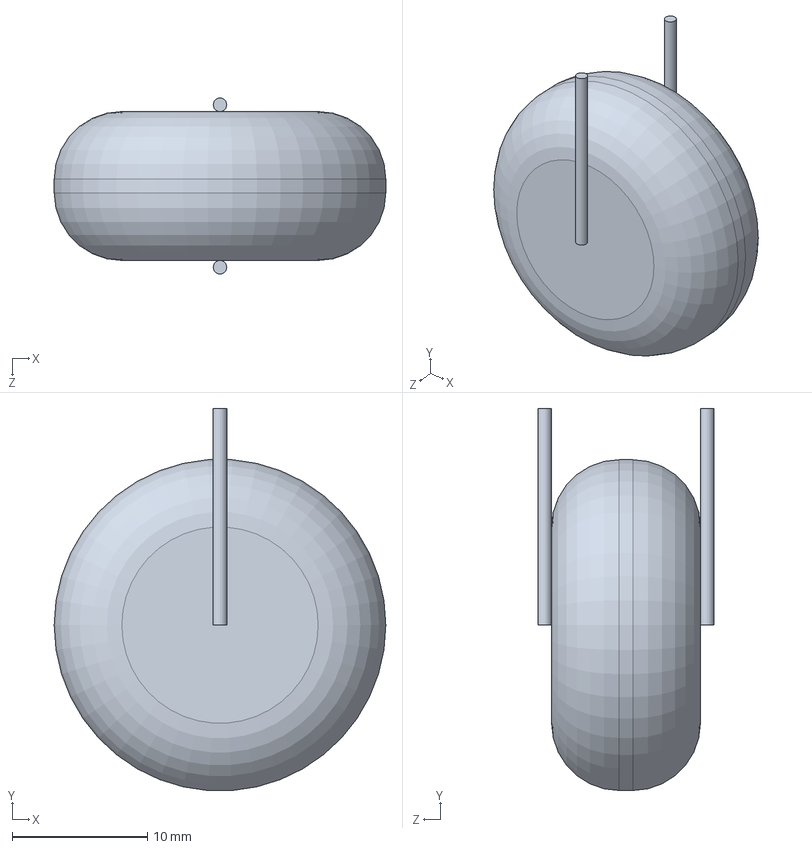
[picture p40: CAD file, 2020-04-03]
3D CAD Models/PB560 Assy/self debout.SLDPRT
24.5 x 28.2 x 13.0 mm
