jawher-Mansour/MedTronic-Ventilator/3D CAD Models/PB560 Assy/entretoise hexa  m3x12.SLDPRT

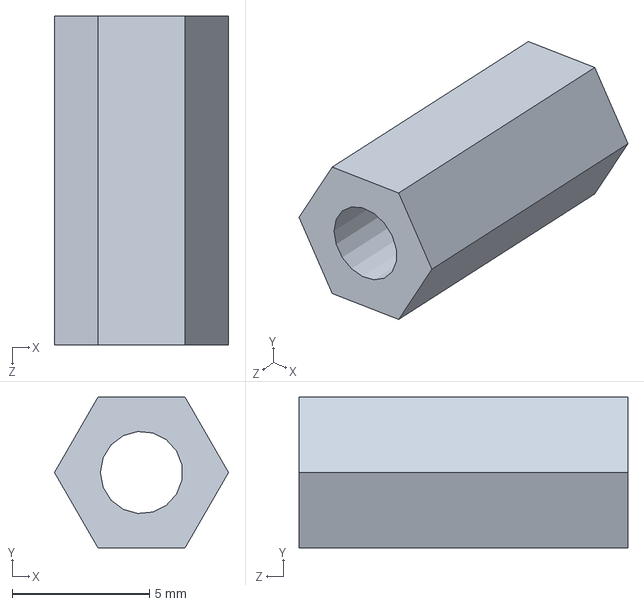
[picture p41: CAD file, 2020-04-03]
3D CAD Models/PB560 Assy/entretoise hexa m3x12.SLDPRT
6.35 x 5.50 x 12.0 mm
