jawher-Mansour/MedTronic-Ventilator/3D CAD Models/PB560 Assy/isolant adhésif capot capteur.SLDPRT

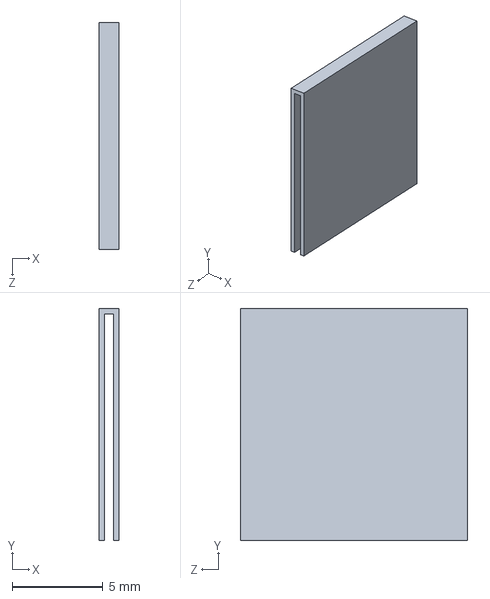
[picture p43: CAD file, 2020-04-03]
3D CAD Models/PB560 Assy/isolant adhésif capot capteur.SLDPRT
1.10 x 12.8 x 12.5 mm
