jawher-Mansour/MedTronic-Ventilator/3D CAD Models/PB560 Assy/regulateur.SLDPRT

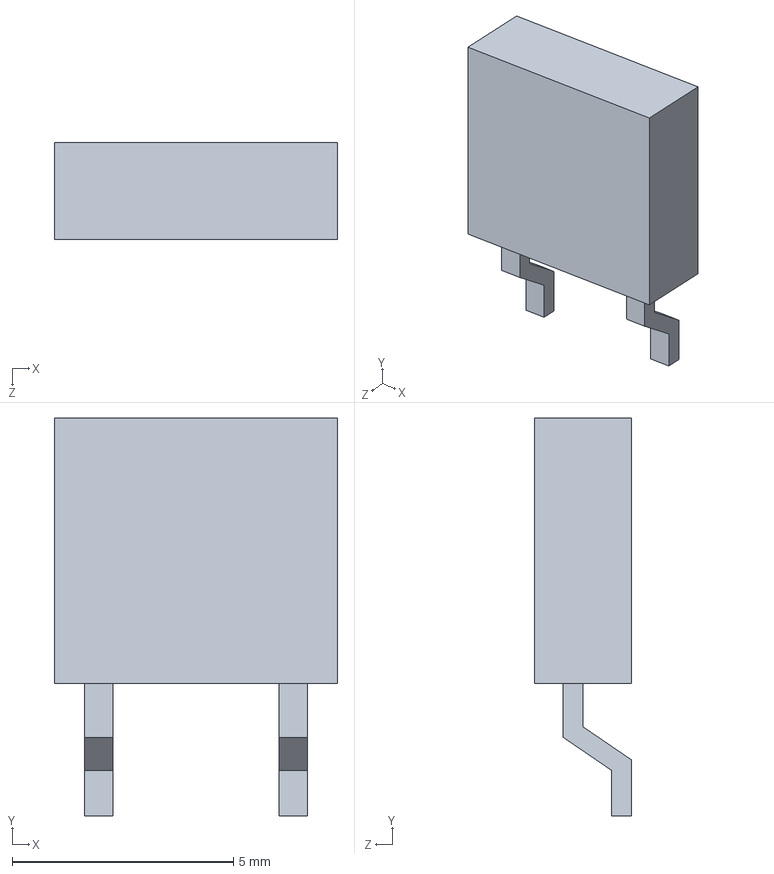
[picture p44: CAD file, 2020-04-03]
3D CAD Models/PB560 Assy/regulateur.SLDPRT
6.40 x 9.00 x 2.20 mm
