jawher-Mansour/MedTronic-Ventilator/3D CAD Models/PB560 Assy/isolant adhésif ens afficheur.SLDPRT

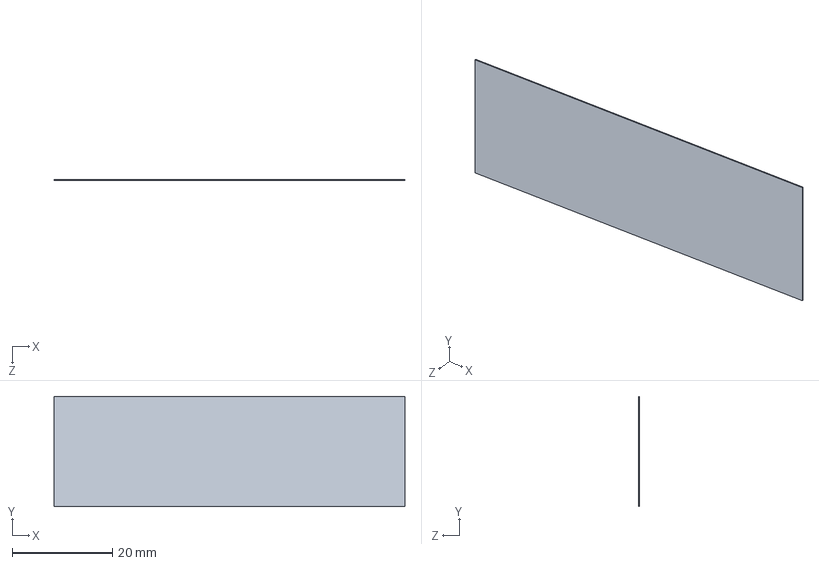
[picture p47: CAD file, 2020-04-03]
3D CAD Models/PB560 Assy/isolant adhésif ens afficheur.SLDPRT
70.0 x 22.0 x 0.2 mm
