jawher-Mansour/MedTronic-Ventilator/3D CAD Models/PB560 Assy/tuyau 15x21 silicone.SLDPRT

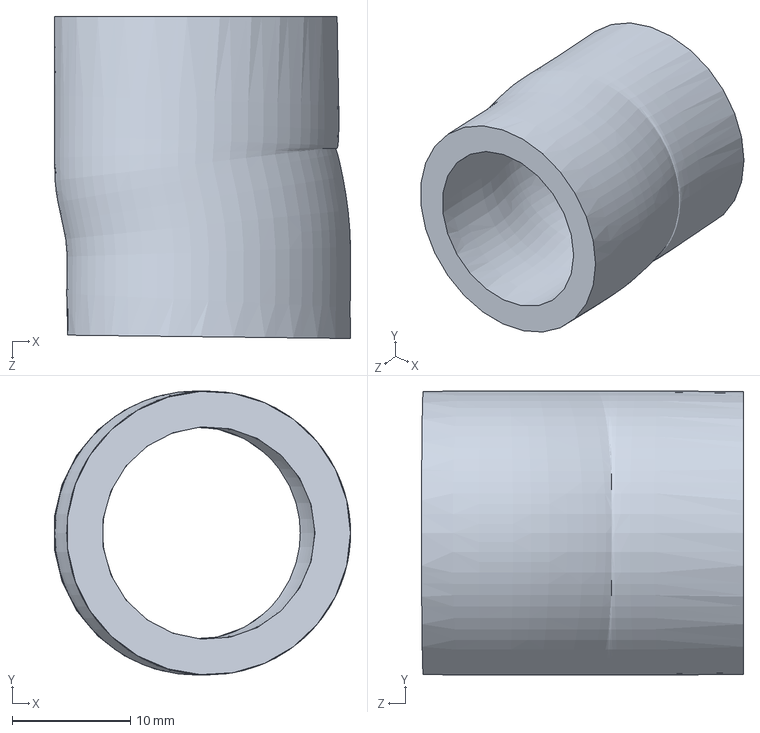
[picture p48: CAD file, 2020-04-03]
3D CAD Models/PB560 Assy/tuyau 15x21 silicone.SLDPRT
25.1 x 24.0 x 27.2 mm
