jawher-Mansour/MedTronic-Ventilator/3D CAD Models/PB560 Assy/capteurpressionASDX001D44R.SLDPRT

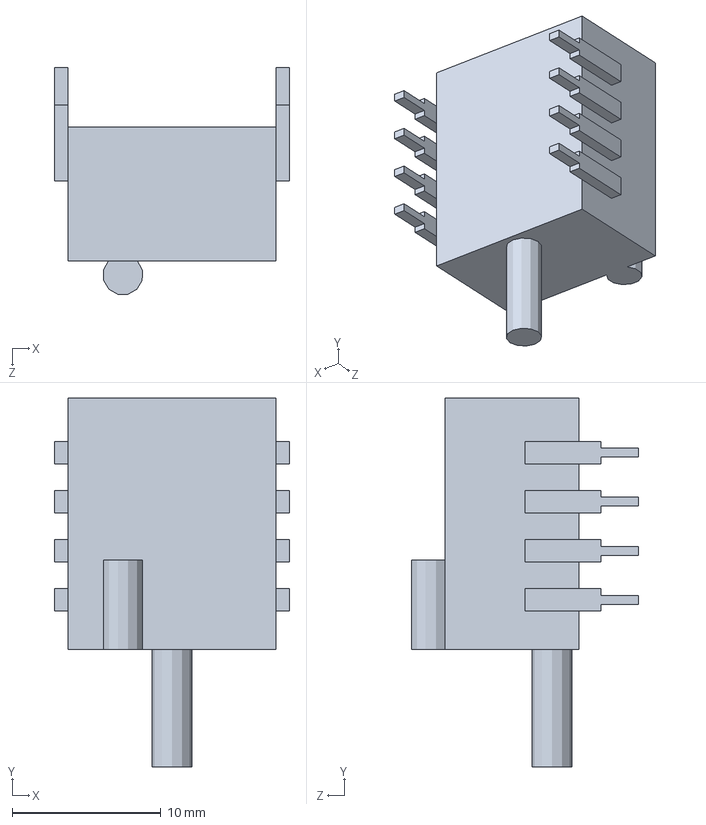
[picture p49: CAD file, 2020-04-03]
3D CAD Models/PB560 Assy/capteurpressionASDX001D44R.SLDPRT
15.8 x 24.8 x 15.2 mm
