jawher-Mansour/MedTronic-Ventilator/3D CAD Models/PB560 Assy/condensateur C88.SLDPRT

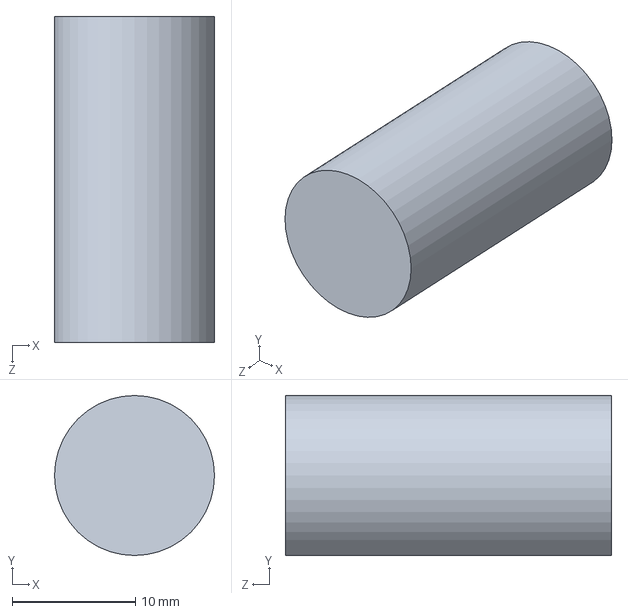
[picture p50: CAD file, 2020-04-03]
3D CAD Models/PB560 Assy/condensateur C88.SLDPRT
13.0 x 13.0 x 26.5 mm
