jawher-Mansour/MedTronic-Ventilator/3D CAD Models/PB560 Assy/MOLEX 43645 0200.SLDPRT

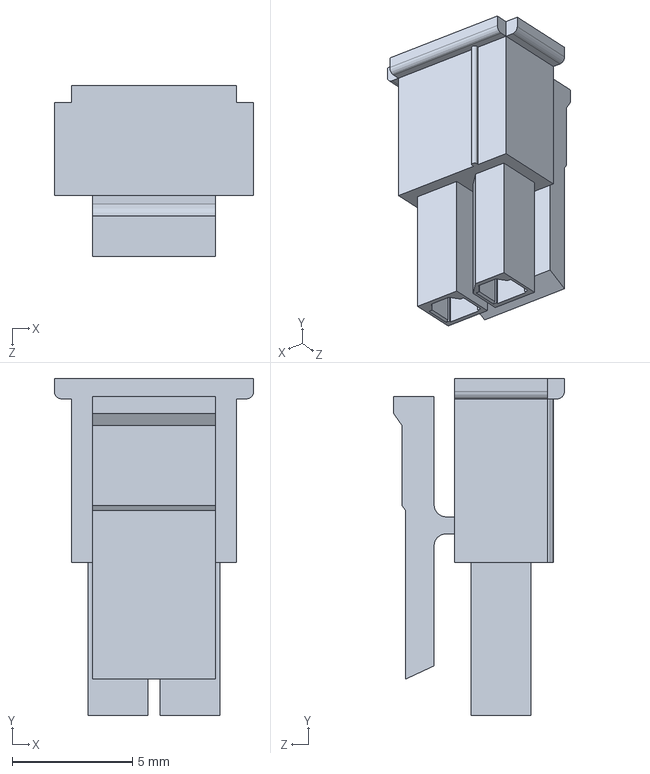
[picture p51: CAD file, 2020-04-03]
3D CAD Models/PB560 Assy/MOLEX 43645 0200.SLDPRT
8.28 x 14.0 x 7.10 mm
