jawher-Mansour/MedTronic-Ventilator/3D CAD Models/PB560 Assy/22-05-7028.SLDPRT

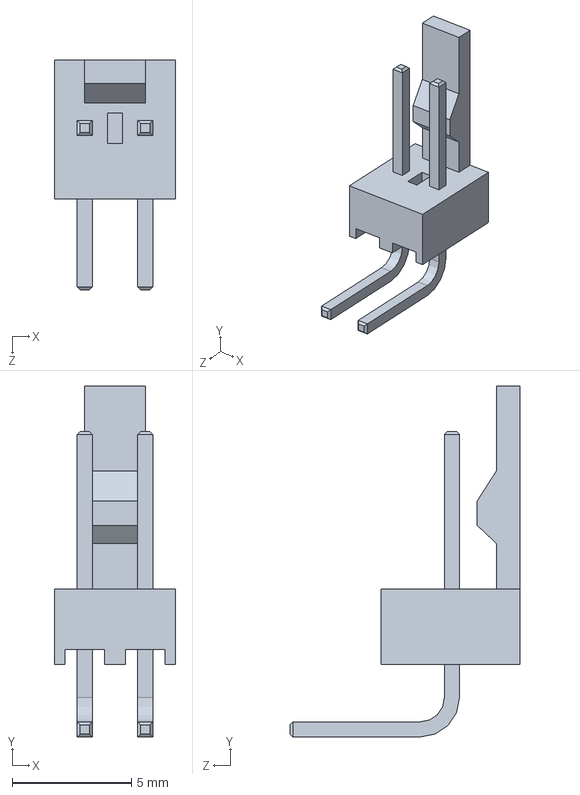
[picture p52: CAD file, 2020-04-03]
3D CAD Models/PB560 Assy/22-05-7028.SLDPRT
5.08 x 14.7 x 9.65 mm
