jawher-Mansour/MedTronic-Ventilator/3D CAD Models/PB560 Assy/MOLEX 43650-0212.SLDPRT

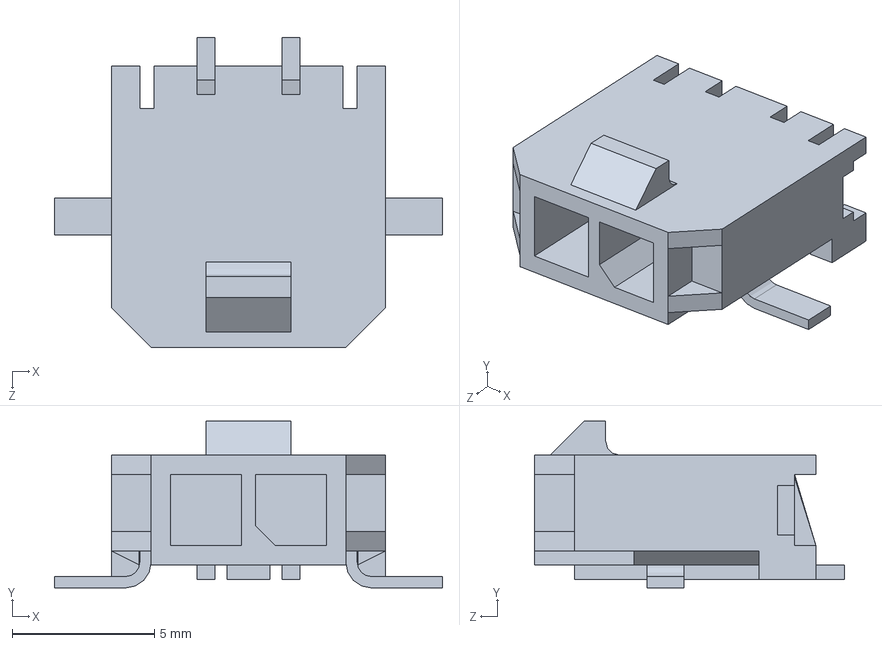
[picture p53: CAD file, 2020-04-03]
3D CAD Models/PB560 Assy/MOLEX 43650-0212.SLDPRT
13.6 x 5.87 x 10.9 mm
