jawher-Mansour/MedTronic-Ventilator/3D CAD Models/PB560 Assy/Coude banjo M5-tuyau 6.SLDPRT

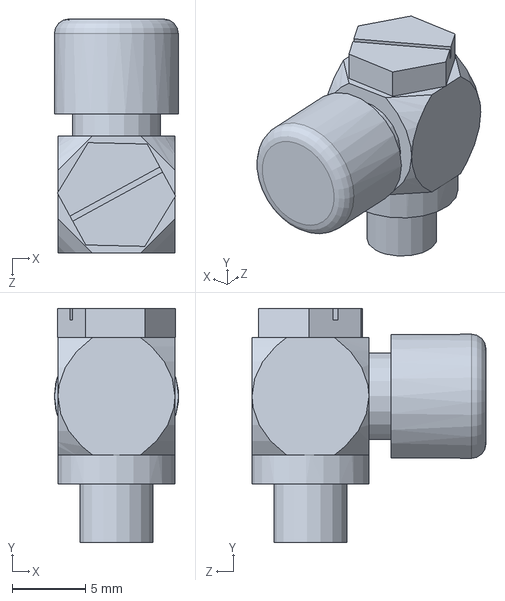
[picture p54: CAD file, 2020-04-03]
3D CAD Models/PB560 Assy/Coude banjo M5-tuyau 6.SLDPRT
8.50 x 16.0 x 16.0 mm
