jawher-Mansour/MedTronic-Ventilator/3D CAD Models/PB560 Assy/26-48-1125.SLDPRT

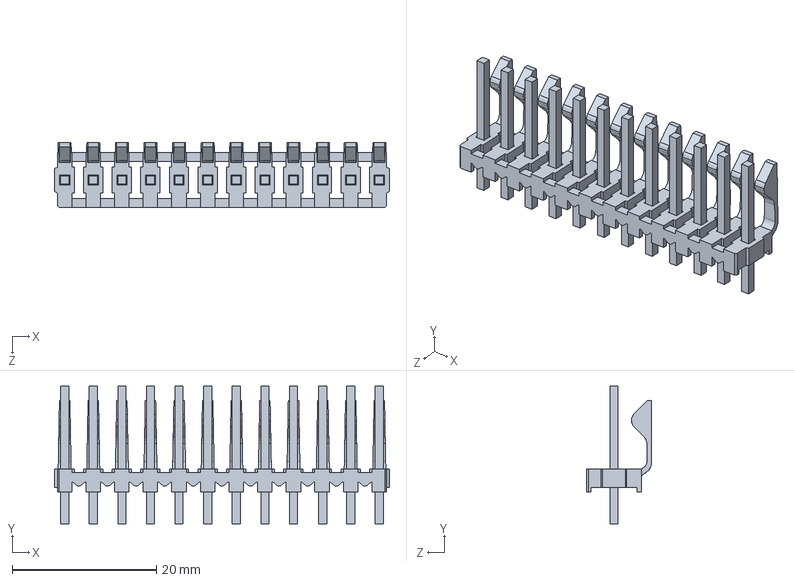
[picture p55: CAD file, 2020-04-03]
3D CAD Models/PB560 Assy/26-48-1125.SLDPRT
46.4 x 19.1 x 9.02 mm
