jawher-Mansour/MedTronic-Ventilator/3D CAD Models/PB560 Assy/tuyau sortie vanne pilot1.6x4.8.SLDPRT

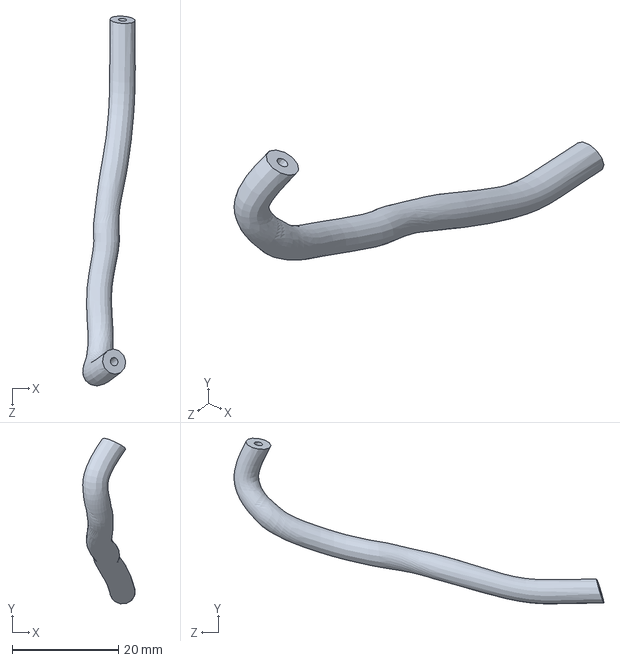
[picture p56: CAD file, 2020-04-03]
3D CAD Models/PB560 Assy/tuyau sortie vanne pilot1.6x4.8.SLDPRT
9.88 x 31.1 x 69.5 mm
