jawher-Mansour/MedTronic-Ventilator/3D CAD Models/PB560 Assy/embase cpu légendair phase 2 ind 01.SLDPRT

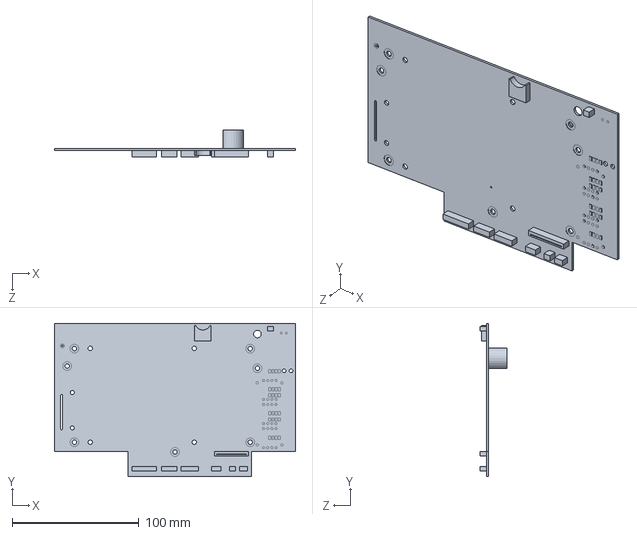
[picture p57: CAD file, 2020-04-03]
3D CAD Models/PB560 Assy/embase cpu légendair phase 2 ind 01.SLDPRT
190.0 x 121.0 x 21.0 mm
