jawher-Mansour/MedTronic-Ventilator/3D CAD Models/PB560 Assy/Exh Valve connector.SLDPRT

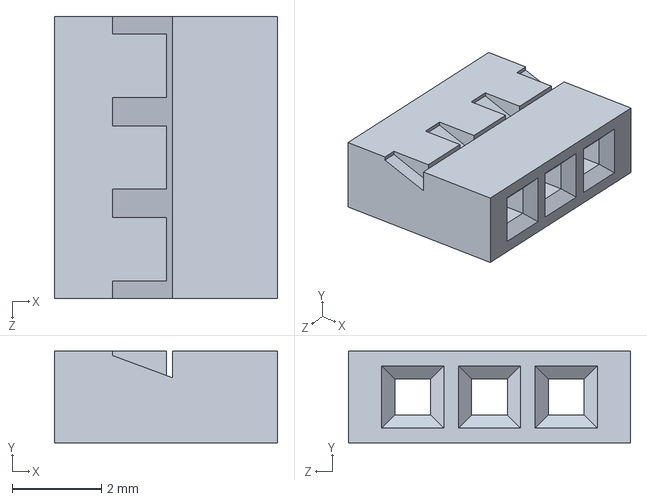
[picture p58: CAD file, 2020-04-03]
3D CAD Models/PB560 Assy/Exh Valve connector.SLDPRT
5.00 x 2.06 x 6.33 mm
