jawher-Mansour/MedTronic-Ventilator/3D CAD Models/PB560 Assy/Molex 90635-1262.SLDPRT

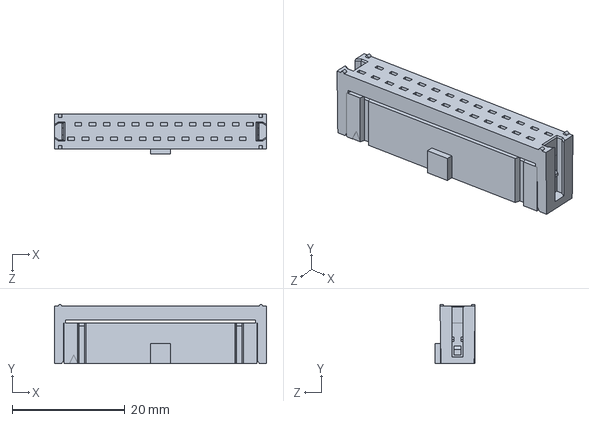
[picture p59: CAD file, 2020-04-03]
3D CAD Models/PB560 Assy/Molex 90635-1262.SLDPRT
37.6 x 10.5 x 7.18 mm
