jawher-Mansour/MedTronic-Ventilator/3D CAD Models/PB560 Assy/Batt Contacts tab.SLDPRT

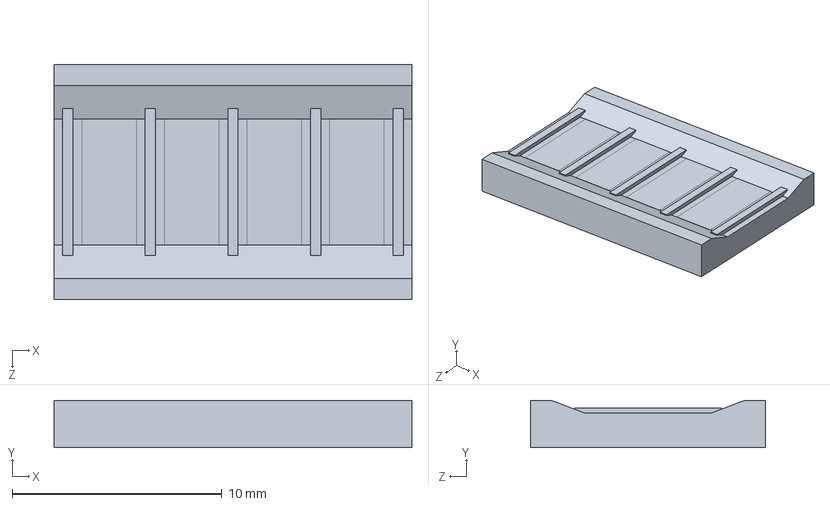
[picture p60: CAD file, 2020-04-03]
3D CAD Models/PB560 Assy/Batt Contacts tab.SLDPRT
17.0 x 2.25 x 11.2 mm
