jawher-Mansour/MedTronic-Ventilator/3D CAD Models/PB560 Assy/INGUN GKS 913 305 230 A 15 02 S.SLDPRT

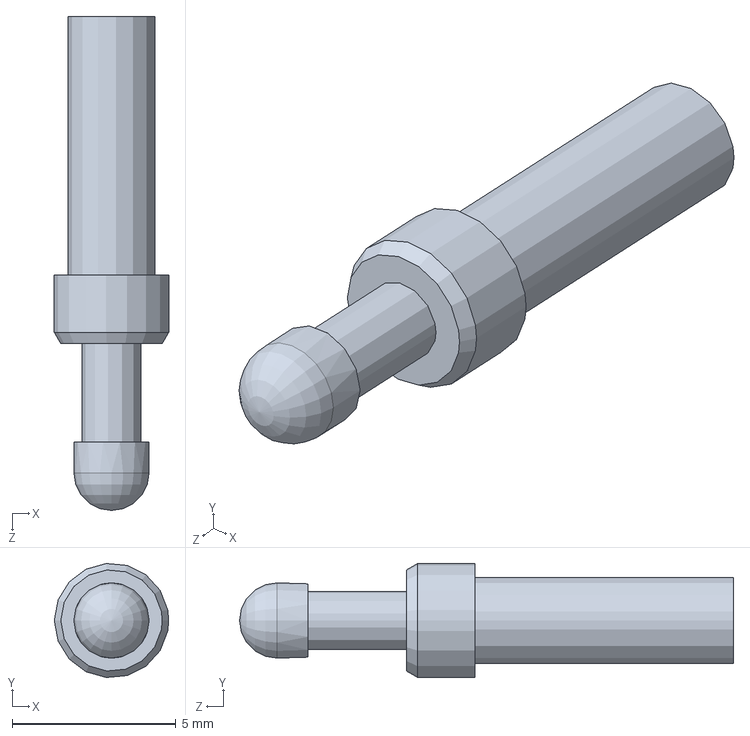
[picture p61: CAD file, 2020-04-03]
3D CAD Models/PB560 Assy/INGUN GKS 913 305 230 A 15 02 S.SLDPRT
3.50 x 3.49 x 15.1 mm
