jawher-Mansour/MedTronic-Ventilator/3D CAD Models/PB560 Assy/3M 4032 x30mm.SLDPRT

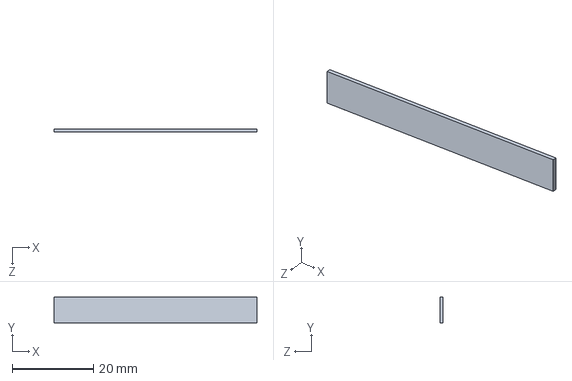
[picture p62: CAD file, 2020-04-03]
3D CAD Models/PB560 Assy/3M 4032 x30mm.SLDPRT
50.0 x 6.35 x 0.8 mm
