jawher-Mansour/MedTronic-Ventilator/3D CAD Models/PB560 Assy/tuyau débit expi P1.SLDPRT

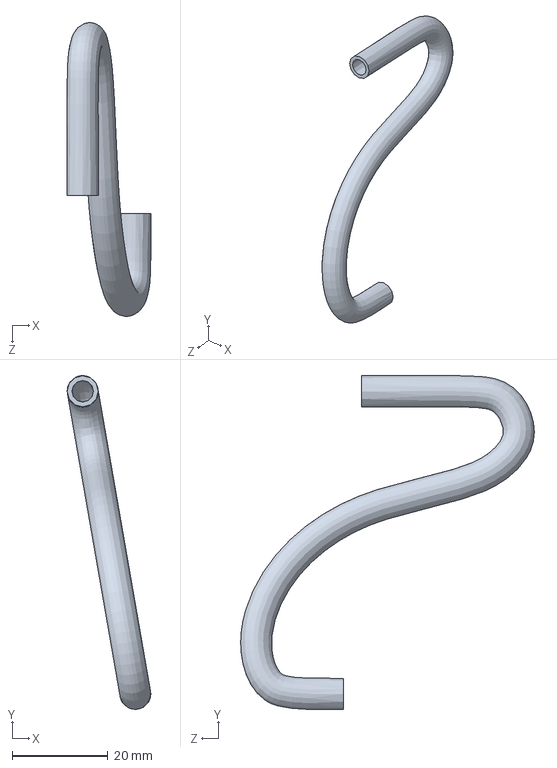
[picture p63: CAD file, 2020-04-03]
3D CAD Models/PB560 Assy/tuyau débit expi P1.SLDPRT
17.5 x 69.7 x 61.3 mm
