jawher-Mansour/MedTronic-Ventilator/3D CAD Models/PB560 Assy/tuyau débit inspi P1.SLDPRT

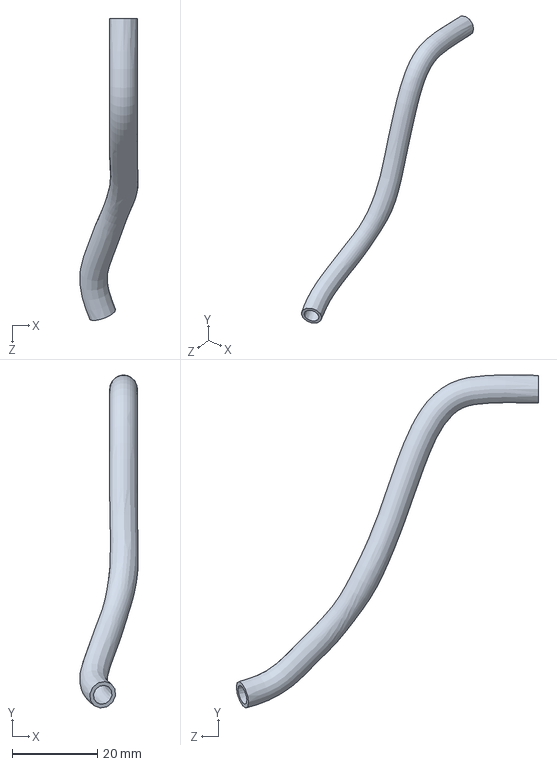
[picture p64: CAD file, 2020-04-03]
3D CAD Models/PB560 Assy/tuyau débit inspi P1.SLDPRT
13.7 x 78.2 x 71.1 mm
