jawher-Mansour/MedTronic-Ventilator/3D CAD Models/PB560 Assy/capteur debit.SLDPRT

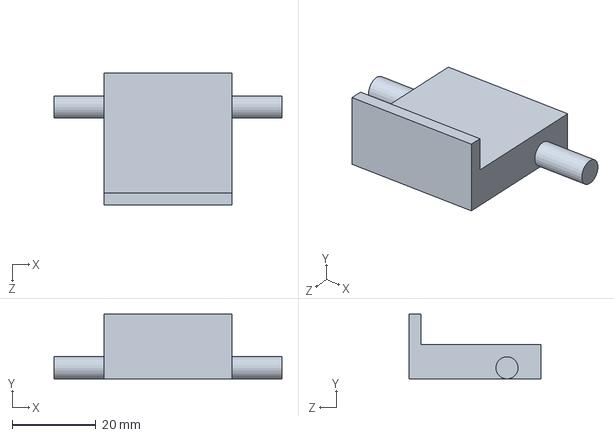
[picture p65: CAD file, 2020-04-03]
3D CAD Models/PB560 Assy/capteur debit.SLDPRT
54.5 x 15.5 x 31.5 mm
