jawher-Mansour/MedTronic-Ventilator/3D CAD Models/PB560 Assy/Extruded housing.SLDPRT

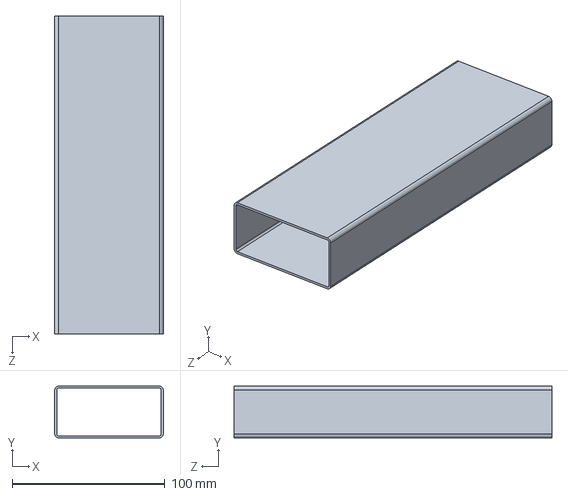
[picture p66: CAD file, 2020-04-03]
3D CAD Models/PB560 Assy/Extruded housing.SLDPRT
71.0 x 34.0 x 208.0 mm
