jawher-Mansour/MedTronic-Ventilator/3D CAD Models/PB560 Assy/entretoise hexa  m3x8.SLDPRT

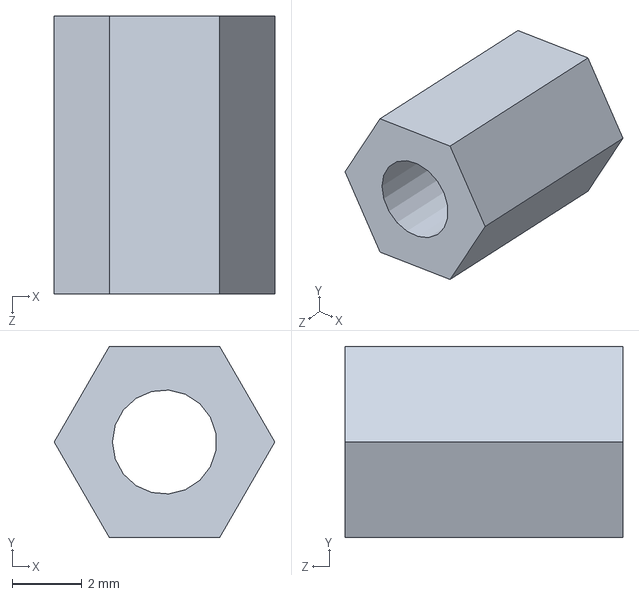
[picture p67: CAD file, 2020-04-03]
3D CAD Models/PB560 Assy/entretoise hexa m3x8.SLDPRT
6.35 x 5.50 x 8.00 mm
