jawher-Mansour/MedTronic-Ventilator/3D CAD Models/PB560 Assy/HIROSE HR30-6R-6S.SLDPRT

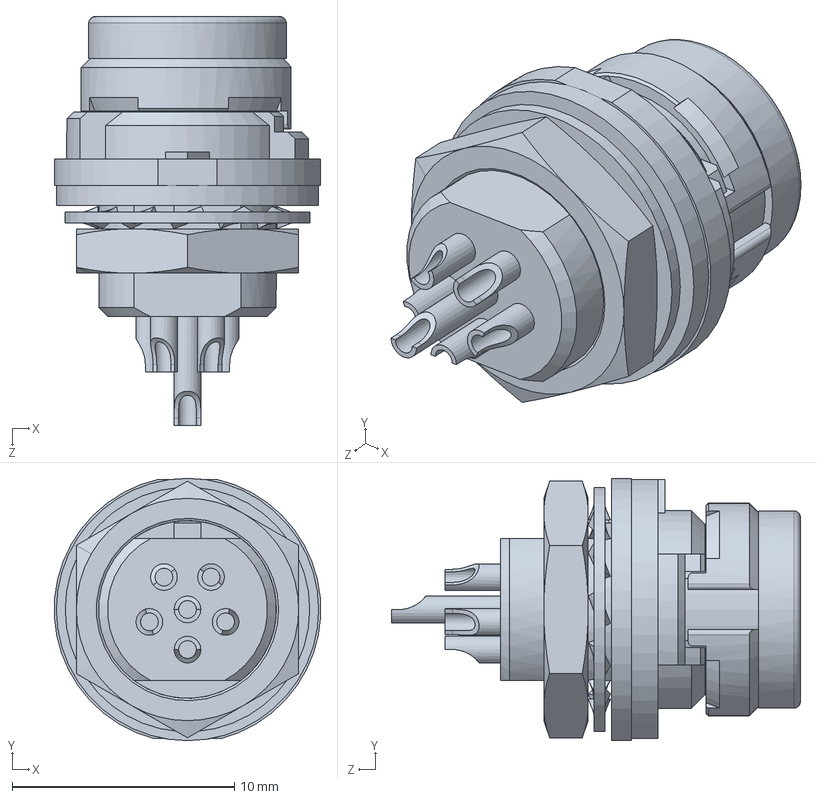
[picture p68: CAD file, 2020-04-03]
3D CAD Models/PB560 Assy/HIROSE HR30-6R-6S.SLDPRT
12.0 x 11.8 x 18.4 mm
