jawher-Mansour/MedTronic-Ventilator/3D CAD Models/PB560 Assy/tuyau  droit sortie vanne O2.SLDPRT

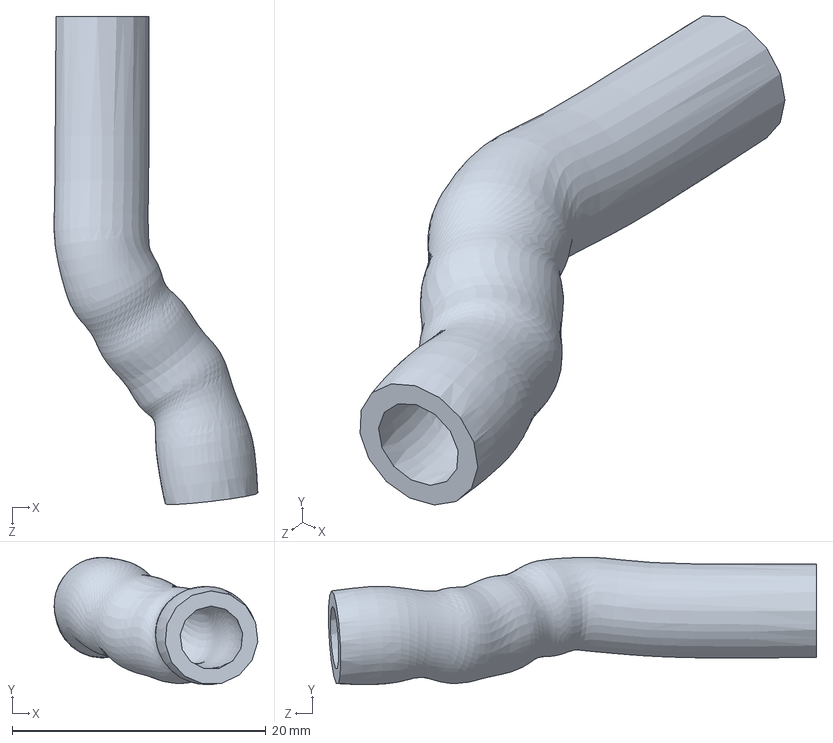
[picture p69: CAD file, 2020-04-03]
3D CAD Models/PB560 Assy/tuyau droit sortie vanne O2.SLDPRT
16.1 x 10.0 x 38.5 mm
