jawher-Mansour/MedTronic-Ventilator/3D CAD Models/PB560 Assy/switch.SLDPRT

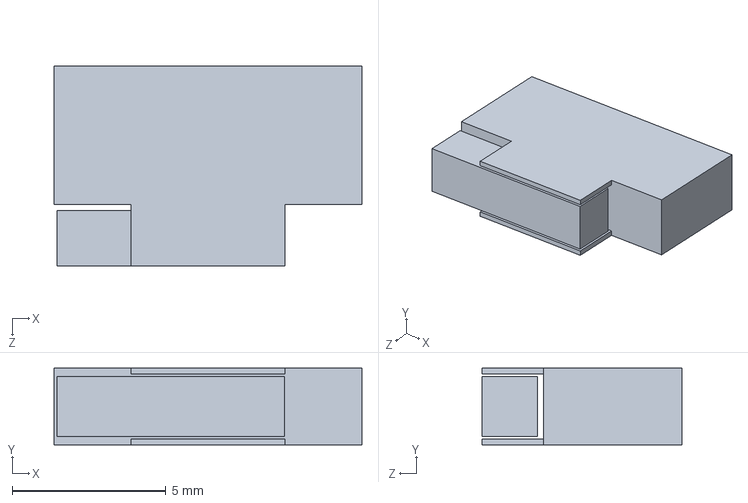
[picture p70: CAD file, 2020-04-03]
3D CAD Models/PB560 Assy/switch.SLDPRT
10.0 x 2.50 x 6.50 mm
