jawher-Mansour/MedTronic-Ventilator/3D CAD Models/PB560 Assy/connect molex 22-01-2087.SLDPRT

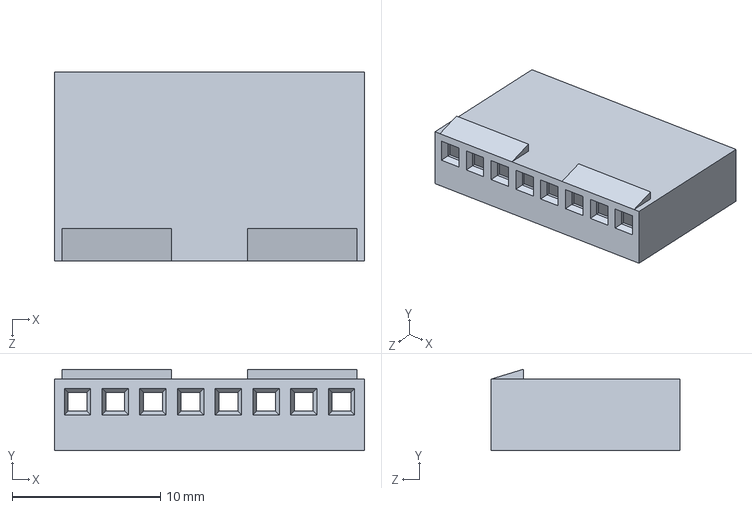
[picture p71: CAD file, 2020-04-03]
3D CAD Models/PB560 Assy/connect molex 22-01-2087.SLDPRT
20.9 x 5.49 x 12.7 mm
