jawher-Mansour/MedTronic-Ventilator/3D CAD Models/PB560 Assy/new circuit support alimentation avec usb.SLDPRT

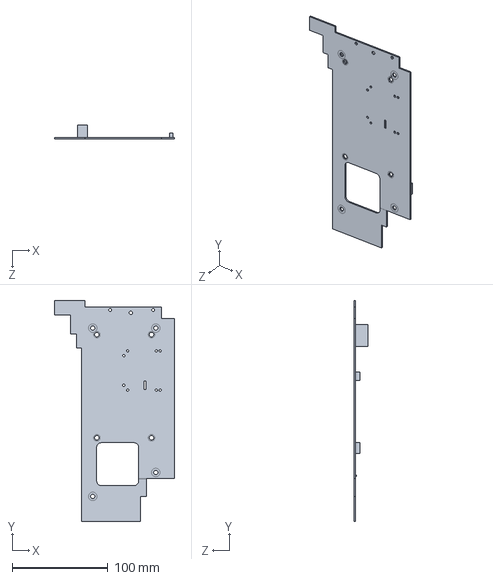
[picture p72: CAD file, 2020-04-03]
3D CAD Models/PB560 Assy/new circuit support alimentation avec usb.SLDPRT
125.9 x 231.2 x 14.8 mm
