jawher-Mansour/MedTronic-Ventilator/3D CAD Models/PB560 Assy/tuyau débit expi P2.SLDPRT

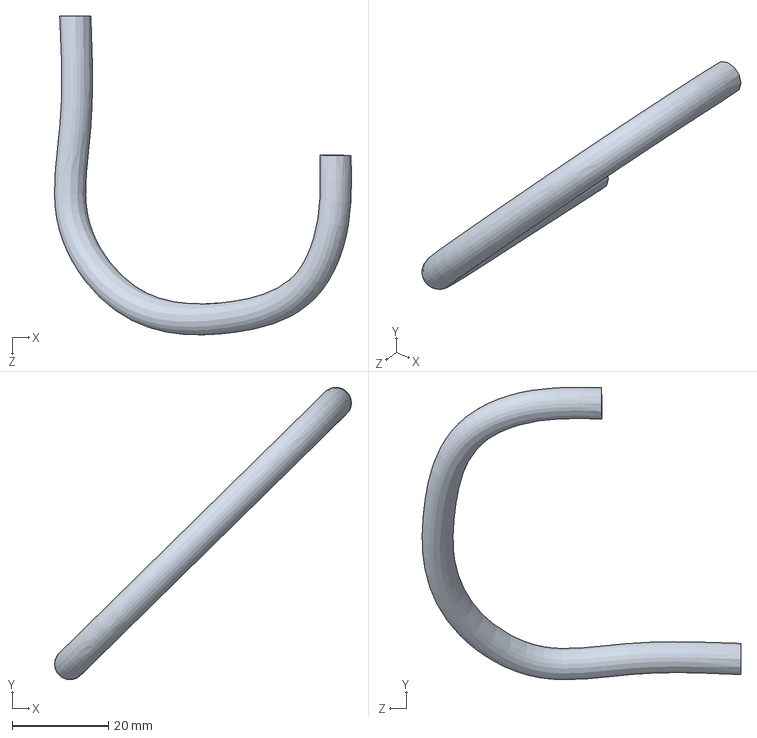
[picture p73: CAD file, 2020-04-03]
3D CAD Models/PB560 Assy/tuyau débit expi P2.SLDPRT
61.8 x 60.8 x 66.3 mm
