jawher-Mansour/MedTronic-Ventilator/3D CAD Models/PB560 Assy/Front End Cap.SLDPRT

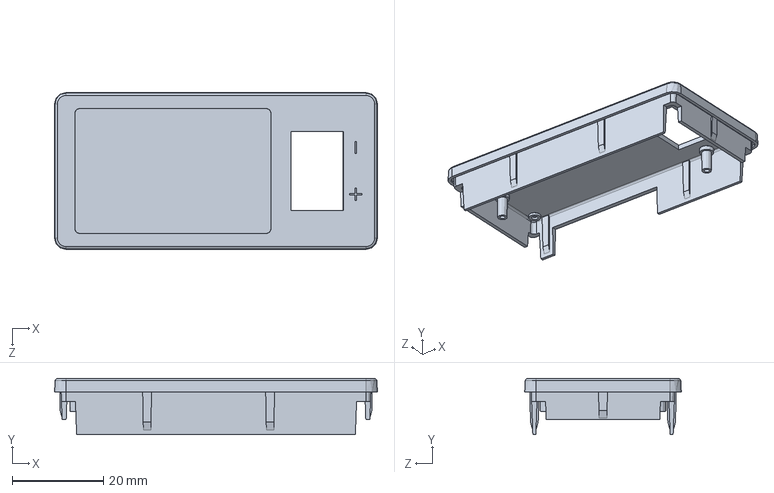
[picture p74: CAD file, 2020-04-03]
3D CAD Models/PB560 Assy/Front End Cap.SLDPRT
70.9 x 12.3 x 34.4 mm
