jawher-Mansour/MedTronic-Ventilator/3D CAD Models/PB560 Assy/carte buzzer.SLDPRT

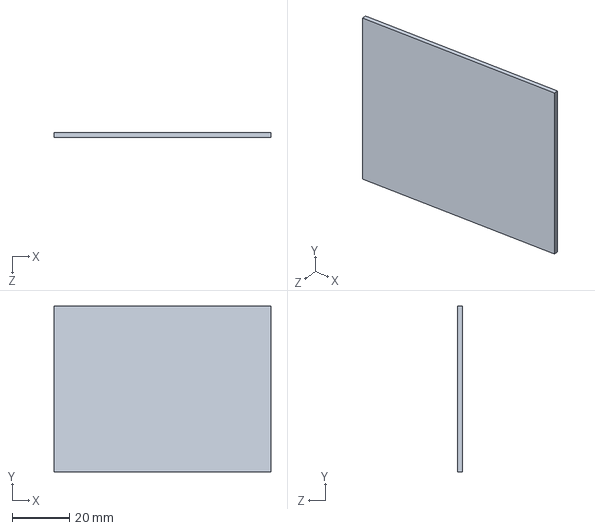
[picture p76: CAD file, 2020-04-03]
3D CAD Models/PB560 Assy/carte buzzer.SLDPRT
76.0 x 58.0 x 1.60 mm
