jawher-Mansour/MedTronic-Ventilator/3D CAD Models/PB560 Assy/Insp Mod Connector.SLDPRT

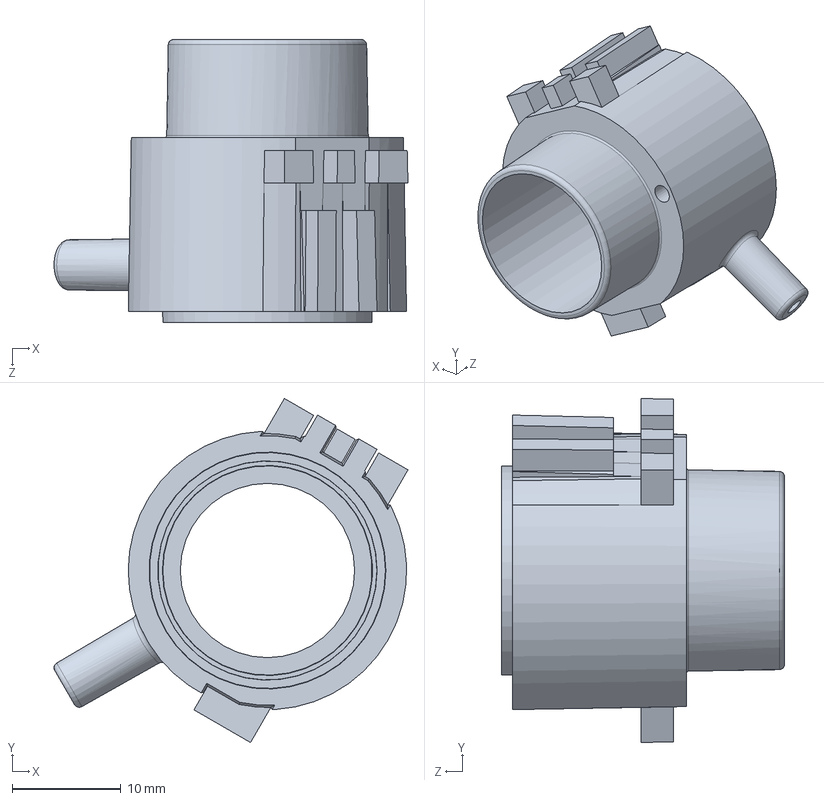
[picture p77: CAD file, 2020-04-03]
3D CAD Models/PB560 Assy/Insp Mod Connector.SLDPRT
32.5 x 31.6 x 26.0 mm
