jawher-Mansour/MedTronic-Ventilator/3D CAD Models/PB560 Assy/connect molex 22-01-2025.SLDPRT

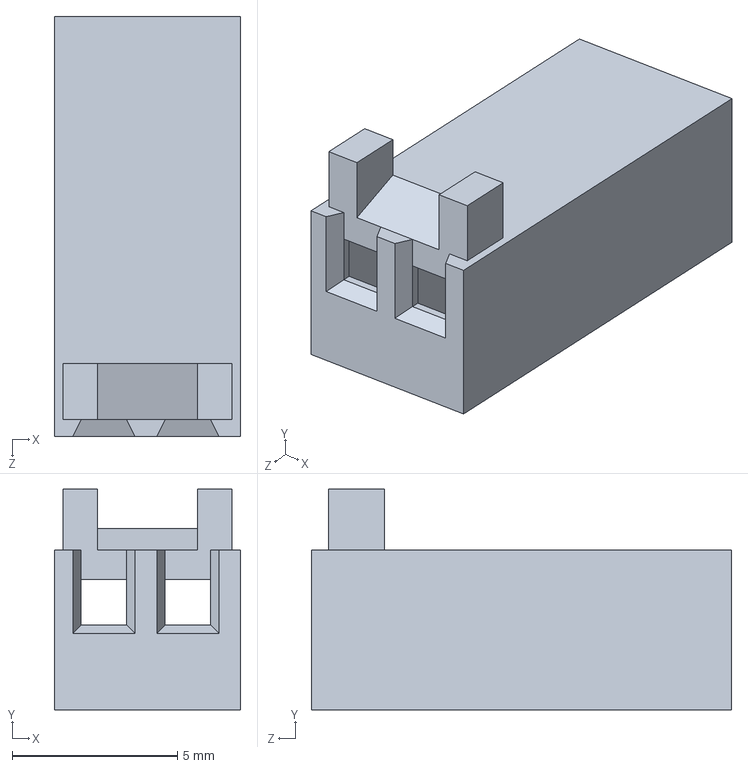
[picture p79: CAD file, 2020-04-03]
3D CAD Models/PB560 Assy/connect molex 22-01-2025.SLDPRT
5.64 x 6.68 x 12.7 mm
