jawher-Mansour/MedTronic-Ventilator/3D CAD Models/PB560 Assy/Vis TCB M3-12 hexalobes acier zingué.sldprt

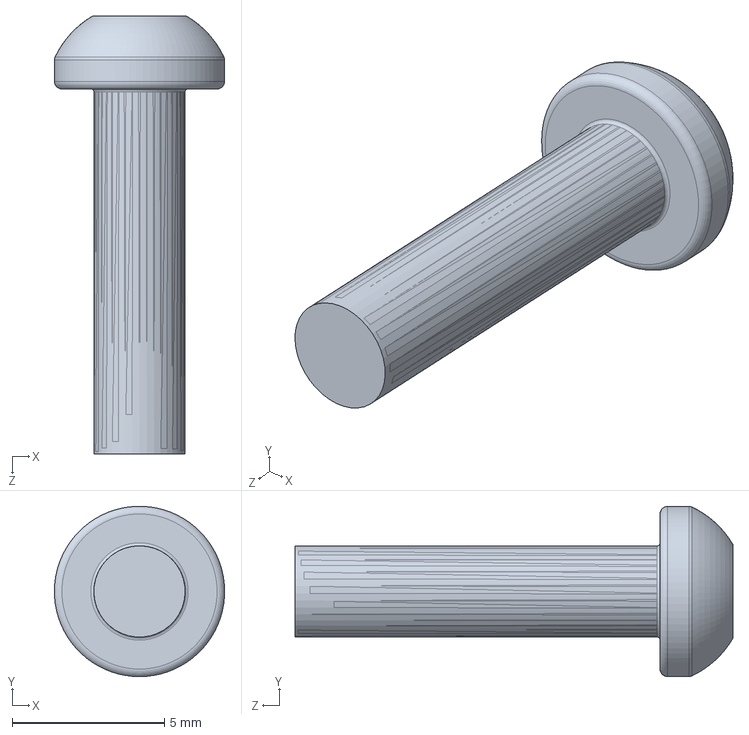
[picture p80: CAD file, 2020-04-03]
3D CAD Models/PB560 Assy/Vis TCB M3-12 hexalobes acier zingué.sldprt
5.60 x 5.60 x 14.4 mm
