jawher-Mansour/MedTronic-Ventilator/3D CAD Models/PB560 Assy/Batt PCB.SLDPRT

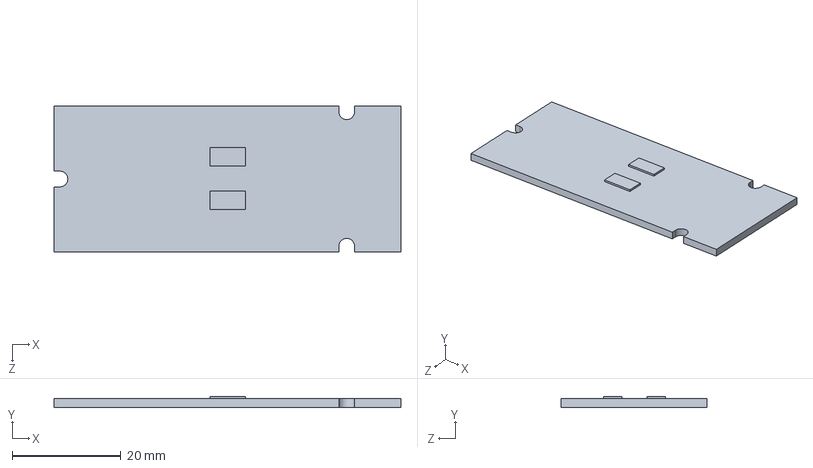
[picture p81: CAD file, 2020-04-03]
3D CAD Models/PB560 Assy/Batt PCB.SLDPRT
63.9 x 2.00 x 26.9 mm
