jawher-Mansour/MedTronic-Ventilator/3D CAD Models/PB560 Assy/Vis KA22x5 hexalobes.SLDPRT

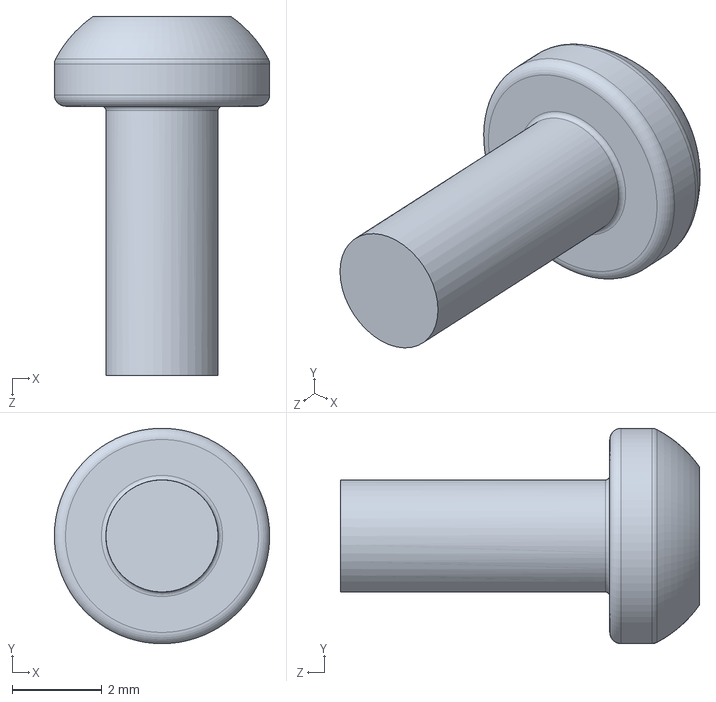
[picture p82: CAD file, 2020-04-03]
3D CAD Models/PB560 Assy/Vis KA22x5 hexalobes.SLDPRT
4.80 x 4.80 x 8.00 mm
