jawher-Mansour/MedTronic-Ventilator/3D CAD Models/PB560 Assy/HARTING 09185107323.SLDPRT

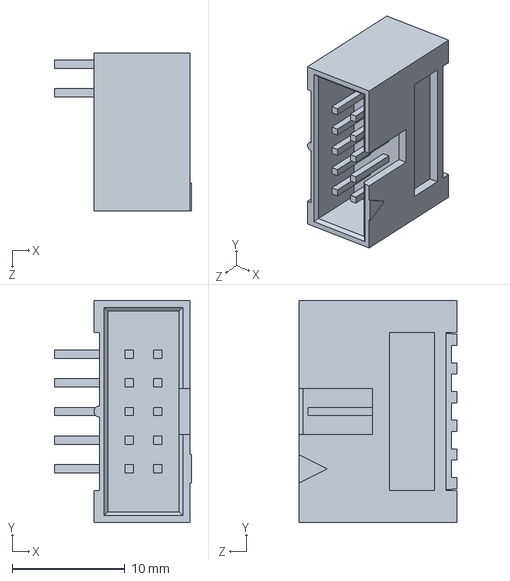
[picture p83: CAD file, 2020-04-03]
3D CAD Models/PB560 Assy/HARTING 09185107323.SLDPRT
12.1 x 19.7 x 14.0 mm
