jawher-Mansour/MedTronic-Ventilator/3D CAD Models/PB560 Assy/Rondelle plate - ZU  3 x 6 EP 0.8.sldprt

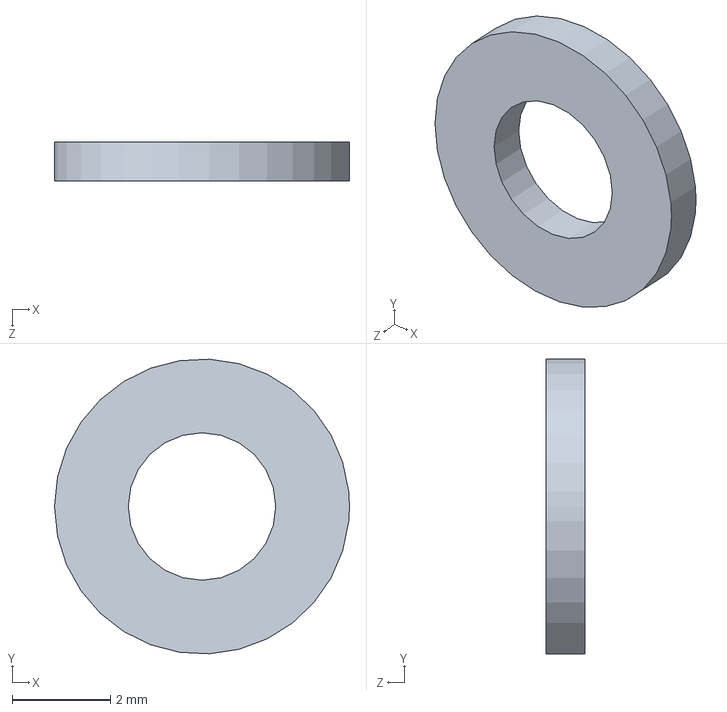
[picture p85: CAD file, 2020-04-03]
3D CAD Models/PB560 Assy/Rondelle plate - ZU 3 x 6 EP 0.8.sldprt
6.00 x 5.99 x 0.8 mm
