jawher-Mansour/MedTronic-Ventilator/3D CAD Models/PB560 Assy/26-48-1035.SLDPRT

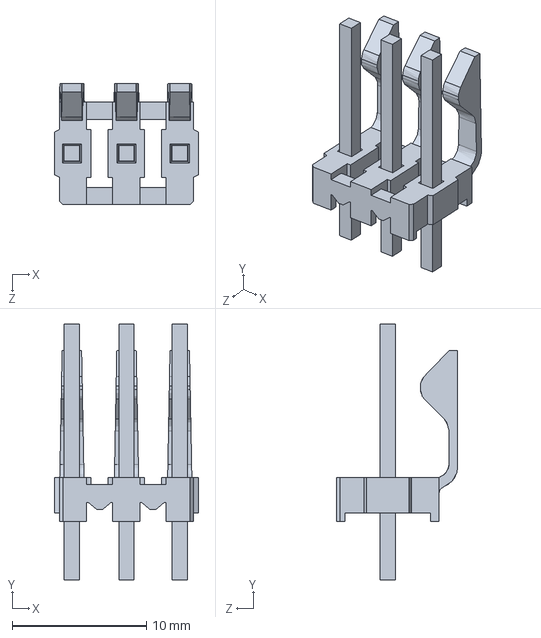
[picture p86: CAD file, 2020-04-03]
3D CAD Models/PB560 Assy/26-48-1035.SLDPRT
10.7 x 19.1 x 9.02 mm
