jawher-Mansour/MedTronic-Ventilator/3D CAD Models/PB560 Assy/I0 179 Entretoise Mediane Legendair.SLDPRT

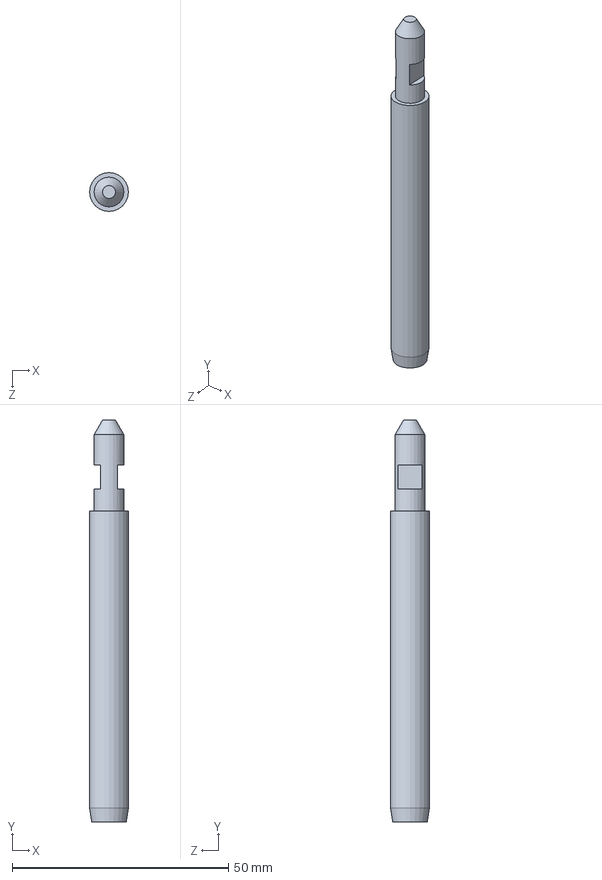
[picture p87: CAD file, 2020-04-03]
3D CAD Models/PB560 Assy/I0 179 Entretoise Mediane Legendair.SLDPRT
9.00 x 93.0 x 9.00 mm
