jawher-Mansour/MedTronic-Ventilator/3D CAD Models/PB560 Assy/MOLEX 22-05-7098.SLDPRT

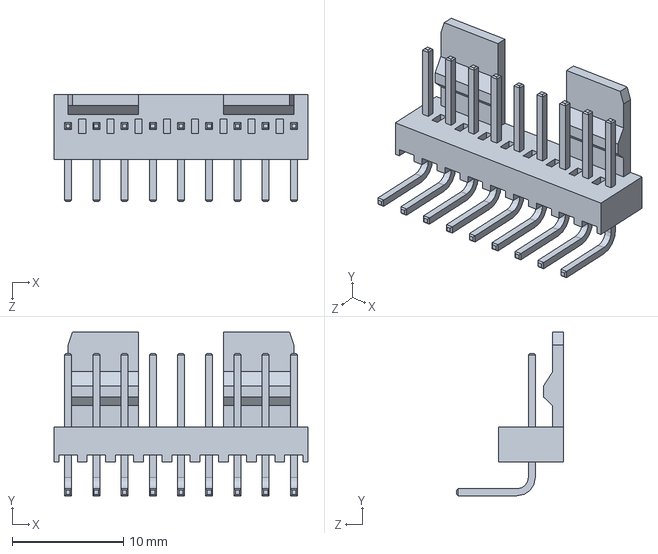
[picture p88: CAD file, 2020-04-03]
3D CAD Models/PB560 Assy/MOLEX 22-05-7098.SLDPRT
22.9 x 14.7 x 9.65 mm
