jawher-Mansour/MedTronic-Ventilator/3D CAD Models/PB560 Assy/connecteur 12-30V.SLDPRT

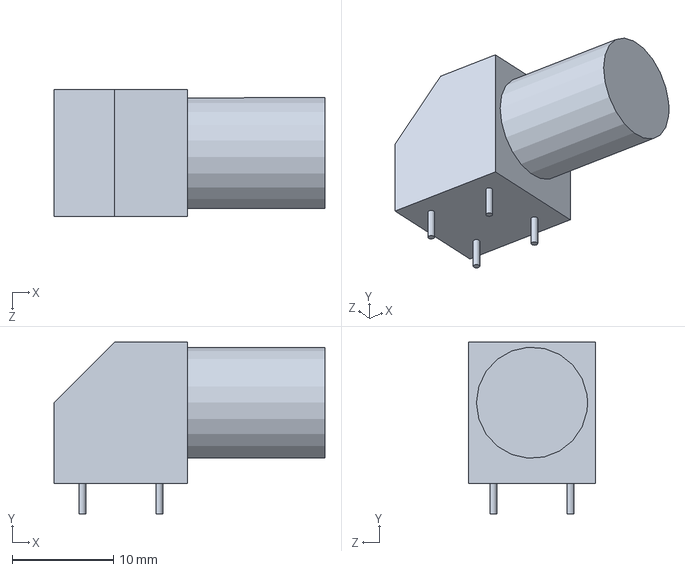
[picture p89: CAD file, 2020-04-03]
3D CAD Models/PB560 Assy/connecteur 12-30V.SLDPRT
26.8 x 17.0 x 12.6 mm
