jawher-Mansour/MedTronic-Ventilator/3D CAD Models/PB560 Assy/39-28-5264.SLDPRT

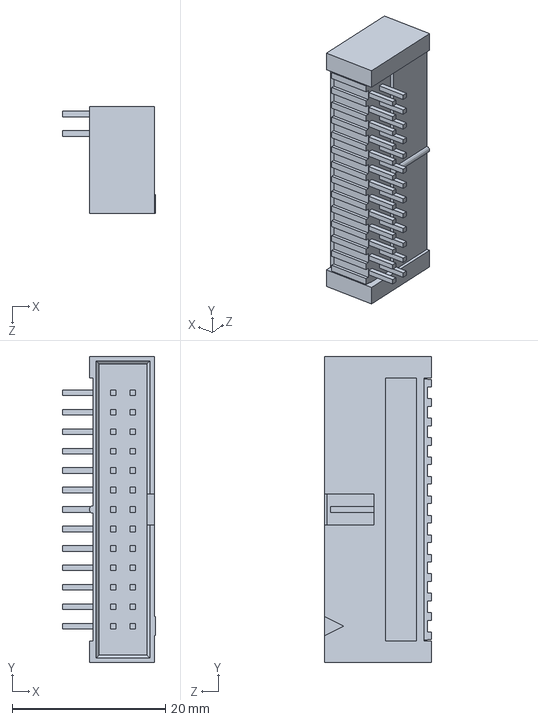
[picture p90: CAD file, 2020-04-03]
3D CAD Models/PB560 Assy/39-28-5264.SLDPRT
12.1 x 40.0 x 14.0 mm
