jawher-Mansour/MedTronic-Ventilator/3D CAD Models/PB560 Assy/cache transfo.SLDPRT

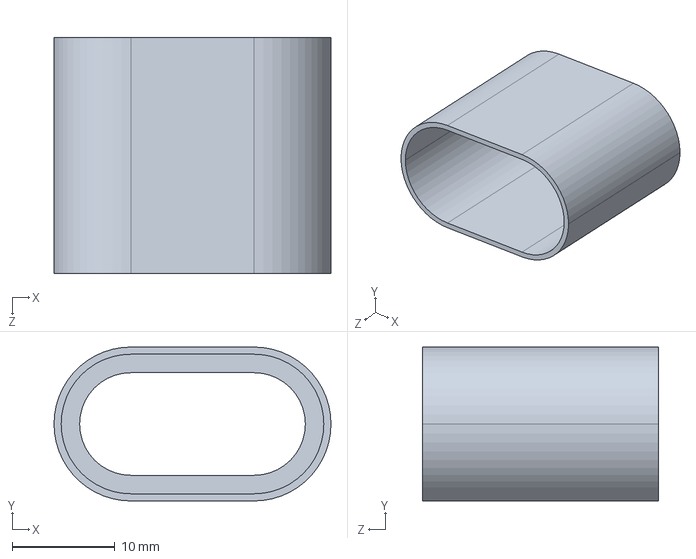
[picture p91: CAD file, 2020-04-03]
3D CAD Models/PB560 Assy/cache transfo.SLDPRT
27.0 x 15.0 x 23.0 mm
