jawher-Mansour/MedTronic-Ventilator/3D CAD Models/PB560 Assy/thermistances CTN.SLDPRT

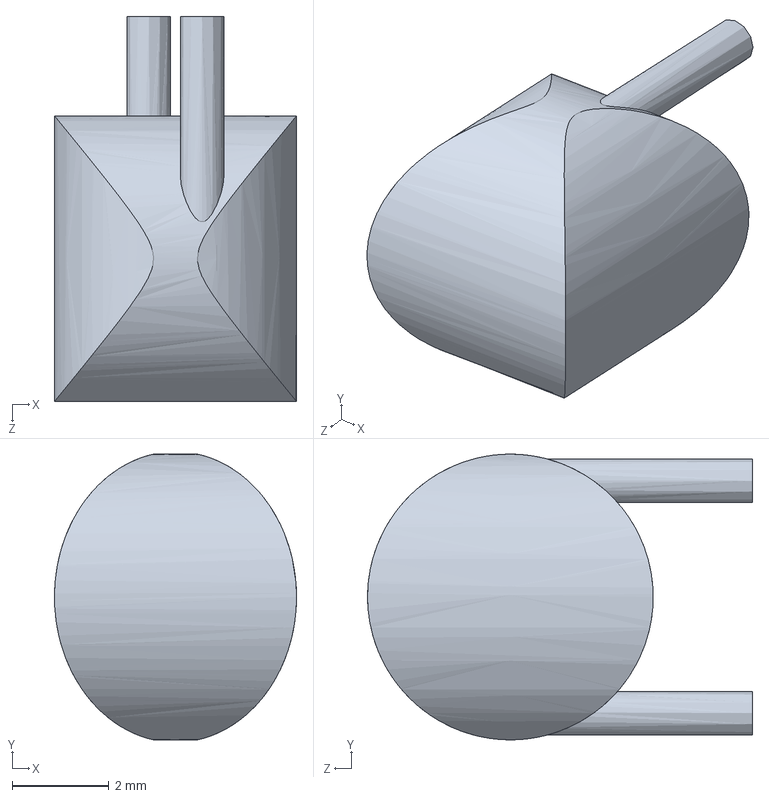
[picture p95: CAD file, 2020-04-03]
3D CAD Models/PB560 Assy/thermistances CTN.SLDPRT
5.00 x 5.90 x 7.95 mm
