jawher-Mansour/MedTronic-Ventilator/3D CAD Models/PB560 Assy/embase cpu.SLDPRT

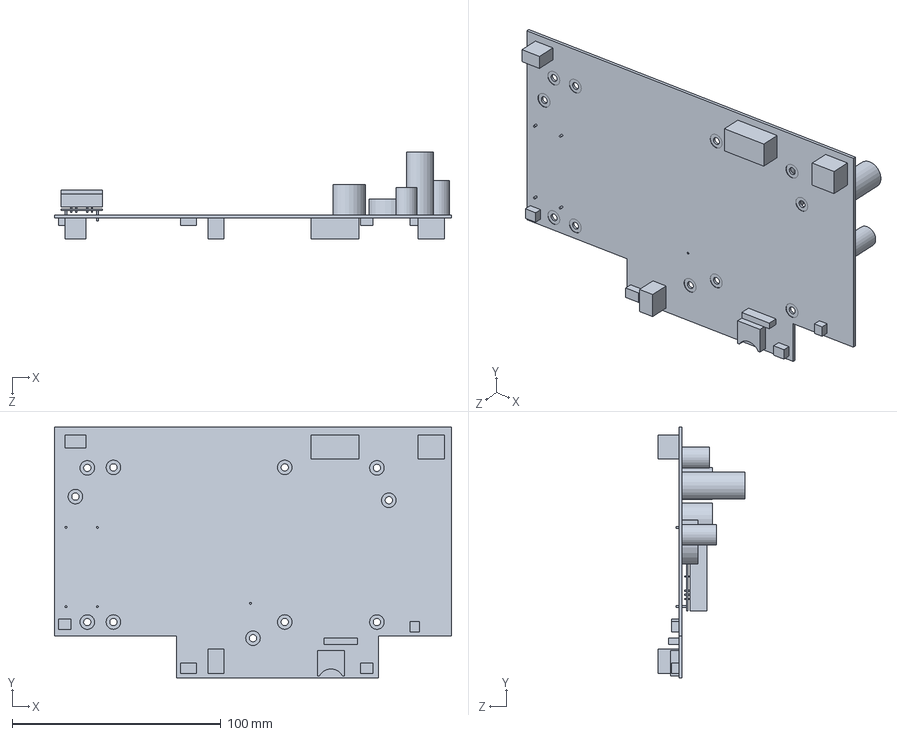
[picture p96: CAD file, 2020-04-03]
3D CAD Models/PB560 Assy/embase cpu.SLDPRT
190.0 x 120.0 x 41.5 mm
