jawher-Mansour/MedTronic-Ventilator/3D CAD Models/PB560 Assy/tuyau O2 entrée vanne.SLDPRT

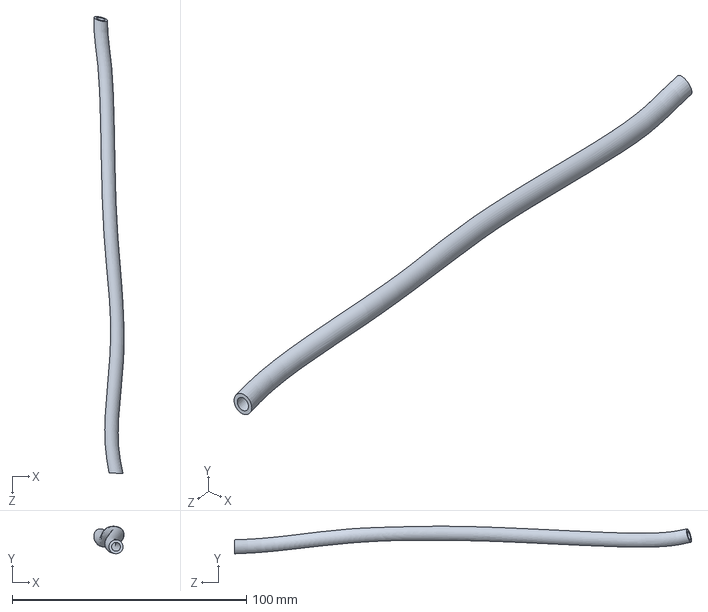
[picture p97: CAD file, 2020-04-03]
3D CAD Models/PB560 Assy/tuyau O2 entrée vanne.SLDPRT
12.9 x 11.8 x 195.1 mm
