jawher-Mansour/MedTronic-Ventilator/3D CAD Models/PB560 Assy/Cable tie (ref AML).SLDPRT

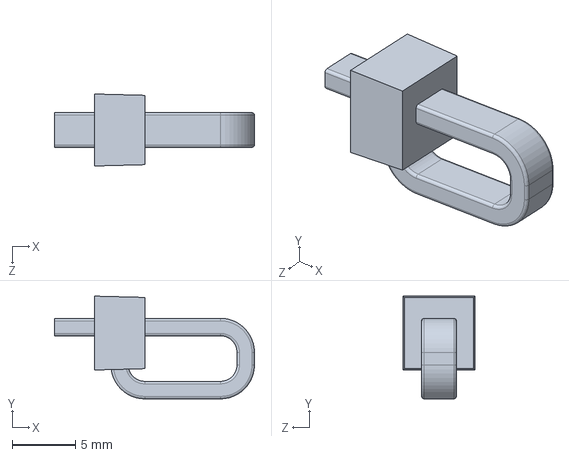
[picture p98: CAD file, 2020-04-03]
3D CAD Models/PB560 Assy/Cable tie (ref AML).SLDPRT
15.9 x 8.15 x 5.71 mm
