jawher-Mansour/MedTronic-Ventilator/3D CAD Models/PB560 Assy/connecteur USB A vertical.SLDPRT

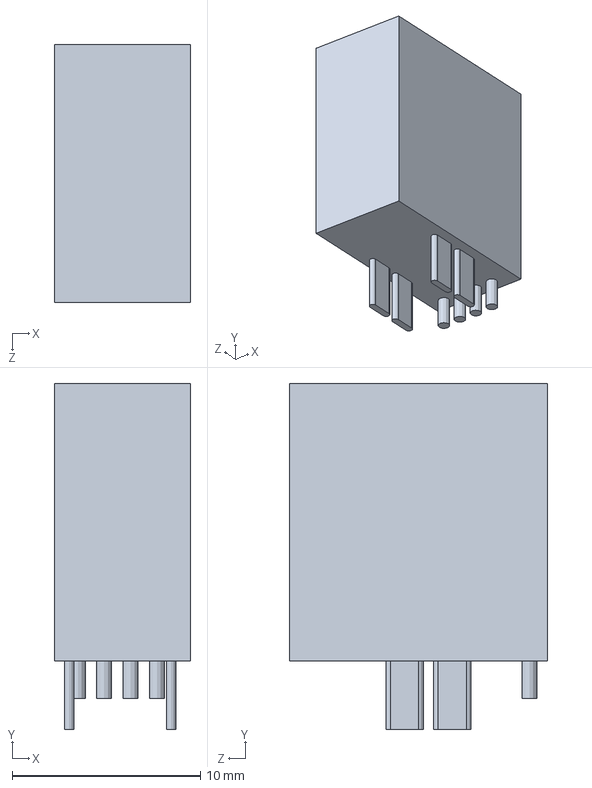
[picture p99: CAD file, 2020-04-03]
3D CAD Models/PB560 Assy/connecteur USB A vertical.SLDPRT
7.25 x 18.4 x 13.7 mm
