jawher-Mansour/MedTronic-Ventilator/3D CAD Models/PB560 Assy/MODULE PRISE 230+INTER.SLDPRT

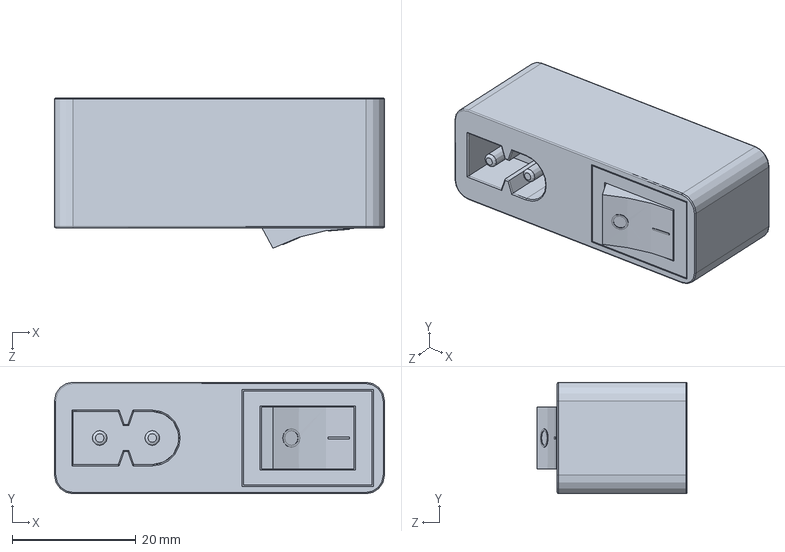
[picture p100: CAD file, 2020-04-03]
3D CAD Models/PB560 Assy/MODULE PRISE 230+INTER.SLDPRT
53.3 x 18.0 x 24.3 mm
