jawher-Mansour/MedTronic-Ventilator/3D CAD Models/PB560 Assy/carte clairitec.SLDPRT

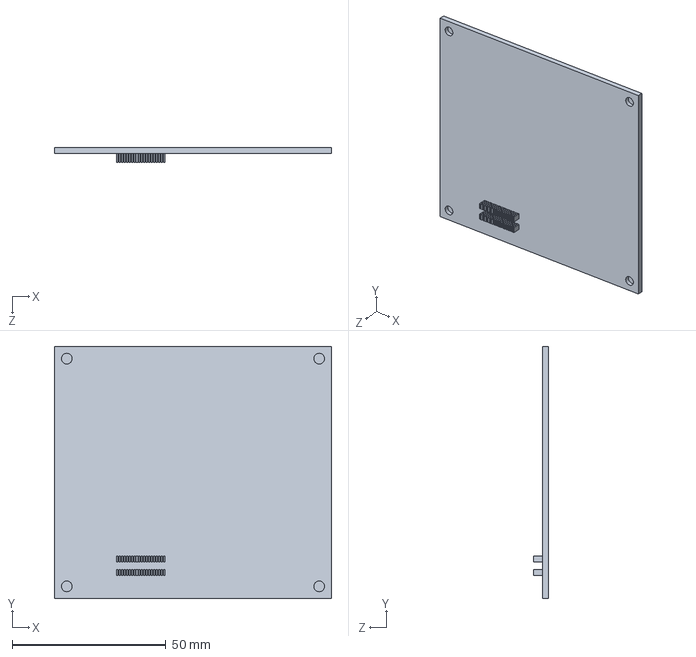
[picture p101: CAD file, 2020-04-03]
3D CAD Models/PB560 Assy/carte clairitec.SLDPRT
90.0 x 82.0 x 5.00 mm
