jawher-Mansour/MedTronic-Ventilator/3D CAD Models/PB560 Assy/boitier capteur pression asdx.SLDPRT

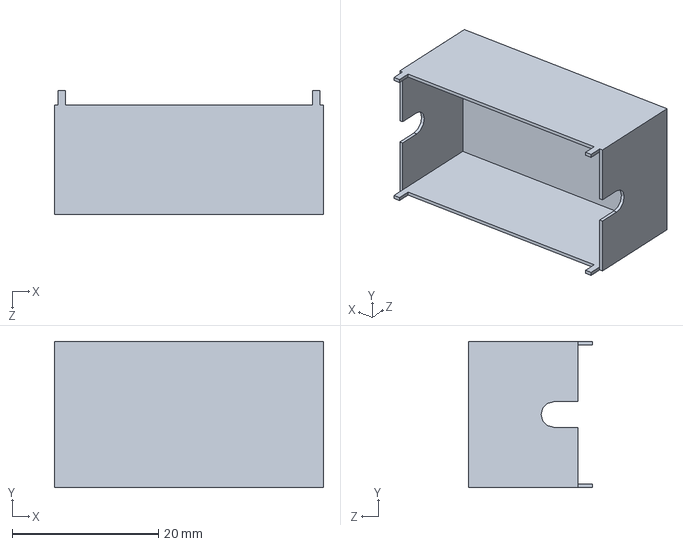
[picture p103: CAD file, 2020-04-03]
3D CAD Models/PB560 Assy/boitier capteur pression asdx.SLDPRT
36.8 x 20.0 x 17.0 mm
