jawher-Mansour/MedTronic-Ventilator/3D CAD Models/PB560 Assy/AFFICHEUR TWIN.SLDPRT

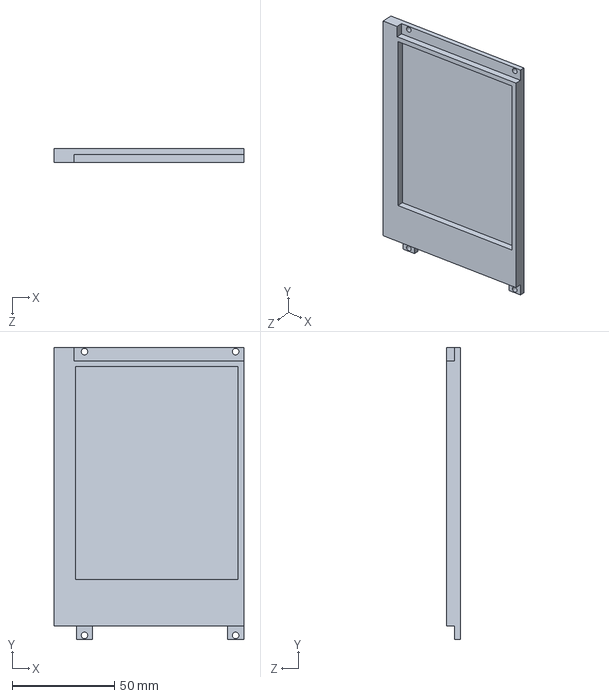
[picture p104: CAD file, 2020-04-03]
3D CAD Models/PB560 Assy/AFFICHEUR TWIN.SLDPRT
92.6 x 142.6 x 7.00 mm
