jawher-Mansour/MedTronic-Ventilator/3D CAD Models/PB560 Assy/Joint blindage conducteur 72x21xép4.SLDPRT

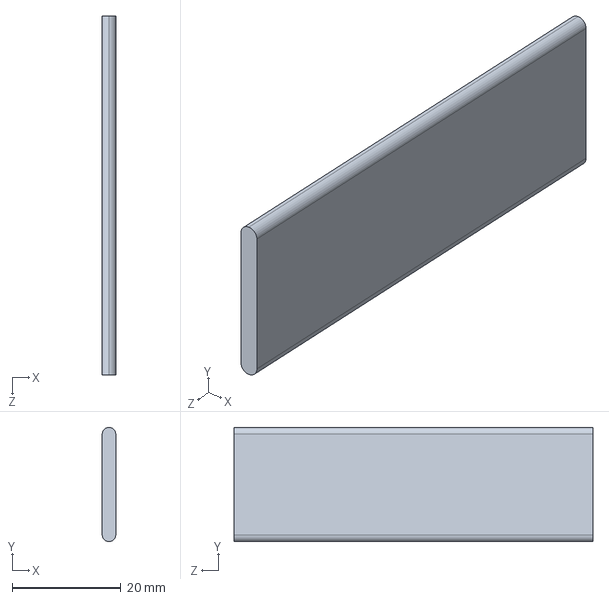
[picture p105: CAD file, 2020-04-03]
3D CAD Models/PB560 Assy/Joint blindage conducteur 72x21xép4.SLDPRT
2.50 x 21.0 x 66.0 mm
