jawher-Mansour/MedTronic-Ventilator/3D CAD Models/PB560 Assy/transfo.SLDPRT

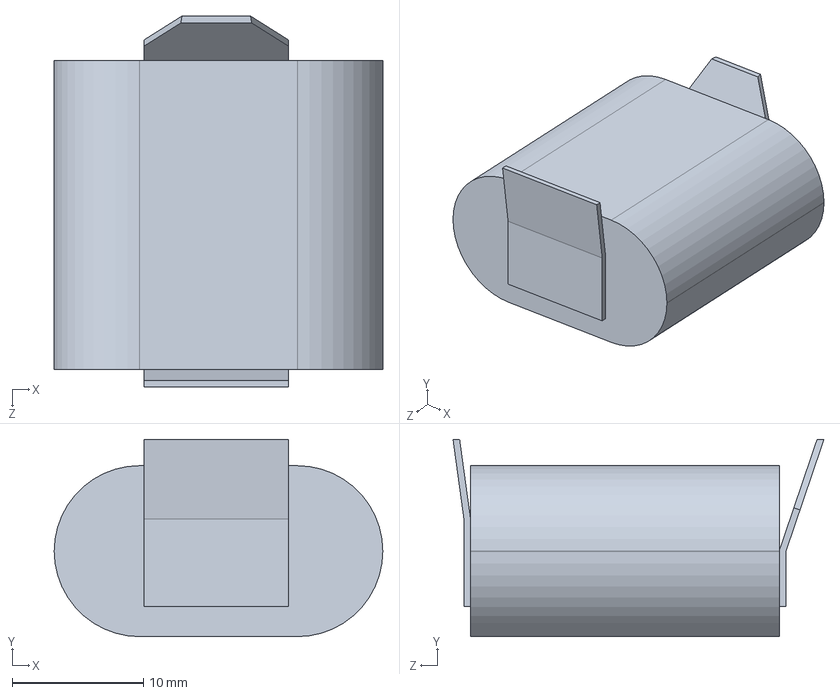
[picture p106: CAD file, 2020-04-03]
3D CAD Models/PB560 Assy/transfo.SLDPRT
25.0 x 15.0 x 28.2 mm
