jawher-Mansour/MedTronic-Ventilator/3D CAD Models/PB560 Assy/condensateur dia 10.SLDPRT

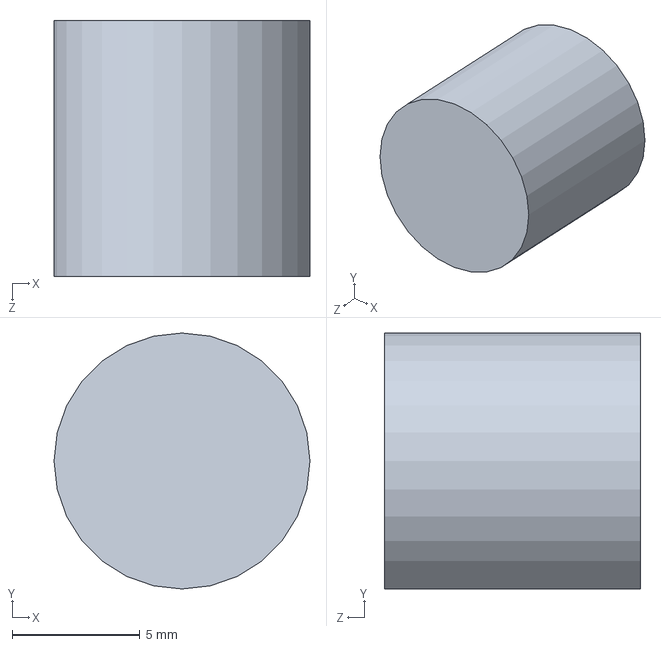
[picture p107: CAD file, 2020-04-03]
3D CAD Models/PB560 Assy/condensateur dia 10.SLDPRT
10.0 x 10.0 x 10.0 mm
