jawher-Mansour/MedTronic-Ventilator/(list of files, cad)

Other CAD files:
3D CAD Models/PB560 Assy/PMCD1204.sldasm
3D CAD Models/PB560 Assy/_PMCD1204_BODY_2.sldprt
3D CAD Models/PB560 Assy/_PMC_LATCH_4.sldprt
3D CAD Models/PB560 Assy/double face.SLDPRT
3D CAD Models/PB560 Assy/filtre murata.SLDPRT
3D CAD Models/PB560 Assy/39-28-5104.SLDPRT
3D CAD Models/PB560 Assy/_100901_6.sldprt
3D CAD Models/PB560 Assy/_100800_8.sldprt
3D CAD Models/PB560 Assy/039281023.SLDPRT
3D CAD Models/PB560 Assy/10049560_Fan Assy (ref ASM).SLDASM
3D CAD Models/PB560 Assy/10049560_Routed wires (asm ref Part).SLDPRT
3D CAD Models/PB560 Assy/10049560_ventil SUNON 40x40x20.SLDPRT
3D CAD Models/PB560 Assy/10079556.SLDASM
3D CAD Models/PB560 Assy/10079556_Support.SLDPRT
3D CAD Models/PB560 Assy/10093284.SLDPRT
3D CAD Models/PB560 Assy/10096315.SLDASM
3D CAD Models/PB560 Assy/10096505_Board (ref ECAD).SLDPRT
3D CAD Models/PB560 Assy/10096509.SLDASM
3D CAD Models/PB560 Assy/10096510.sldasm
3D CAD Models/PB560 Assy/10096510_Bare Board.SLDPRT
3D CAD Models/PB560 Assy/10096511.SLDASM
3D CAD Models/PB560 Assy/10096512.SLDASM
3D CAD Models/PB560 Assy/10100017.SLDPRT
3D CAD Models/PB560 Assy/10100018.SLDPRT
3D CAD Models/PB560 Assy/2004200 Rondelle plate - MN INOX 3 x 8 EP 0.8.sldprt
3D CAD Models/PB560 Assy/2877500 mousse adhesive 3x20 Légendair.SLDPRT
3D CAD Models/PB560 Assy/2931200 mousse ép 10mm .SLDPRT
3D CAD Models/PB560 Assy/2957500 Vis TCB D 3.5 x 8 hexalobes acier zingué.sldprt
3D CAD Models/PB560 Assy/2957600 Vis TCB D 3.5 x 16 hexalobes acier zingué.sldprt
3D CAD Models/PB560 Assy/2960100 Vis TCB M3-8 hexalobes acier zingué.sldprt
3D CAD Models/PB560 Assy/2960600 Vis TF M4 x 10 hexalobes acier zingué.sldprt
3D CAD Models/PB560 Assy/2961500 Pieds autocollants 12.7x12.7 ep5.8.SLDPRT
3D CAD Models/PB560 Assy/2963500 batterie legendair.SLDPRT
3D CAD Models/PB560 Assy/2963800 Vis tête fraisée M3 x 8.SLDPRT
3D CAD Models/PB560 Assy/2964000 traversée cloison PMC4202.SLDPRT
3D CAD Models/PB560 Assy/2966100 Vis TCB M3 x 5 exalobes acier zingué .SLDPRT
3D CAD Models/PB560 Assy/2966300 (ref AML).SLDPRT
3D CAD Models/PB560 Assy/2970100 goupille cylindrique DIA 2x28.SLDPRT
3D CAD Models/PB560 Assy/2970300 raccord droit 2.4x3.2 plastique.SLDPRT
3D CAD Models/PB560 Assy/2970400 Raccord TE 2.4 plastique.SLDPRT
3D CAD Models/PB560 Assy/2970800 Vis TCB D 3 x 6 hexalobes acier zingué.SLDPRT
3D CAD Models/PB560 Assy/2970900 vanne A-M O2 FAS.SLDPRT
3D CAD Models/PB560 Assy/2970999 Vanne A-M O2 FAS.SLDASM
3D CAD Models/PB560 Assy/2971600 collier adhésif ajustable.SLDPRT
3D CAD Models/PB560 Assy/2973900 (ref AML).SLDPRT
3D CAD Models/PB560 Assy/2980100 ferrite 18.8x28.5x13.2.SLDPRT
3D CAD Models/PB560 Assy/3804800 Filtre entrée d'air.SLDPRT
3D CAD Models/PB560 Assy/3808400.SLDASM
3D CAD Models/PB560 Assy/3808801 support cone expiration legendair.SLDPRT
3D CAD Models/PB560 Assy/3809700 Bouton moleté imperdable.SLDPRT
3D CAD Models/PB560 Assy/3810200.SLDPRT
3D CAD Models/PB560 Assy/3812400 entretoise hexa M-F M3.SLDPRT
3D CAD Models/PB560 Assy/3812500 tole blindage toron moteur.SLDPRT
3D CAD Models/PB560 Assy/3814200.SLDPRT
3D CAD Models/PB560 Assy/3814400 ressort capot.SLDPRT
3D CAD Models/PB560 Assy/3822000.SLDPRT
3D CAD Models/PB560 Assy/3822500.SLDASM
3D CAD Models/PB560 Assy/3822500_WIRES.SLDPRT
3D CAD Models/PB560 Assy/3823200 exterieur poignée.SLDPRT
3D CAD Models/PB560 Assy/3823200 intérieure poignée.SLDPRT
3D CAD Models/PB560 Assy/3823200.sldasm
3D CAD Models/PB560 Assy/3824300 Assy with labels (ref Assy).SLDASM
3D CAD Models/PB560 Assy/3824300_Main block.SLDPRT
3D CAD Models/PB560 Assy/3824300_Plastic Insert.SLDPRT
3D CAD Models/PB560 Assy/3825500.SLDPRT
3D CAD Models/PB560 Assy/3825700 étiq éxpiration usage unique.SLDPRT
3D CAD Models/PB560 Assy/3826102 étiquette rappel alarme.SLDPRT
3D CAD Models/PB560 Assy/3826300 étiquette ATTENTION SECTEUR.SLDPRT
3D CAD Models/PB560 Assy/3827900.SLDPRT
3D CAD Models/PB560 Assy/3828200 etiq ident caisson turbine.SLDPRT
3D CAD Models/PB560 Assy/3828200.SLDPRT
3D CAD Models/PB560 Assy/3828299 REF ASSY (INCLUDES FOAM).SLDASM
3D CAD Models/PB560 Assy/3828703 étiquette US o2.SLDPRT
3D CAD Models/PB560 Assy/3828800 etiq entrée d'air symbolisée.SLDPRT
3D CAD Models/PB560 Assy/3838600 etiq ID+code barre revB.SLDPRT
3D CAD Models/PB560 Assy/3838600 étiquette traçabilité .SLDPRT
3D CAD Models/PB560 Assy/3838600.SLDPRT
3D CAD Models/PB560 Assy/3839402 etiq sortie d'air symbolisée.SLDPRT
3D CAD Models/PB560 Assy/3839403 étiquette connexion valve.sldprt
3D CAD Models/PB560 Assy/3845900_ferrite tube plat 1,3x6,5 prof10 larg 40.SLDPRT
3D CAD Models/PB560 Assy/3846100.SLDASM
3D CAD Models/PB560 Assy/3846100_Cable.SLDPRT
3D CAD Models/PB560 Assy/4096600 étiquette identification XL2.SLDPRT
3D CAD Models/PB560 Assy/4096600.M00.023 boitier capteur debit.SLDPRT
3D CAD Models/PB560 Assy/43650-0224.SLDPRT
3D CAD Models/PB560 Assy/60601-1 Test Finger.SLDPRT
3D CAD Models/PB560 Assy/90151-2110.SLDPRT
3D CAD Models/PB560 Assy/901700010 avec patte.SLDPRT
3D CAD Models/PB560 Assy/90635-1102 +90170-0010 molex avec patte.SLDASM
3D CAD Models/PB560 Assy/90635-1102.SLDPRT
3D CAD Models/PB560 Assy/valve chiprop .SLDPRT
Manufacturing Fixtures/10021741_A.dwg
Manufacturing Fixtures/10021744 Approved Revision A.dwg
Manufacturing Fixtures/10025172 A00.dwg
Mechanical Part Drawings/10053480/10053480B01.dwg
Mechanical Part Drawings/10080310/10080310/10080310E00.dwg
Mechanical Part Drawings/10080310/10080310E00.dwg
Mechanical Part Drawings/2963300/10049690/PT00010010/PT00010010A00.dwg
Mechanical Part Drawings/2963300/10049690/PT00010010/PT00010010X0100.dwg
Mechanical Part Drawings/2963300/2963300.SLDDRW
Mechanical Part Drawings/5094000/5094000N00.dwg
